DJ027X/nu.ai_motor_controller/README.md

# nu.ai_motor_controller
Designed with KiCAD 5.

You'll also want to grab my custom KiCAD library repo, otherwise parts may not load in.
