DJ027X/nu.ai_motor_controller/nu.ai_motor_controller_firmware/README.txt

To flash firmware onto the conrtoller:
1. Connect the controller to the host machine via USB A to microUSB cable.
2. Hold the ON button on the controller.
3. Run 'bash flash.sh' on the host machine
4. When the flashing process is done, release the ON button, and press the OFF button.
