DJ027X/nu.ai_motor_controller/nu.ai_motor_controller_firmware/firmware_design_document.odt

nu.ai_motor_controller_firmware Design Documentation

Author: Dylan Dailey (djd9617@rit.edu)

Date: April 5 2019

Firmware Version: 1.0

Document Version 1.0

1.0 Overview

The following is an overview of the systems instantiated by the firmware, and which peripherals on the 32u4 microcontroller they occupy.

1.1 Buzzer

The buzzer utilizes timer/counter 0 to generate a desired frequency. The frequency is set by writing a value to OCR0A using the formula OCR0A = 31250 / frequency. For example, to achieve ~440 Hz, one would write 71 (0x47) to OCR0A. OC0A is toggles on a compare match, which will toggle the value of pin 12 (PB7) (PWM_0A), so no interrupts are required to generate the waveform. To enable the output of the waveform, the pin (PB7) must be set as an output. To disable it, PB7 must be set as an input. As discussed in the next section, the timer/counter 3 can also be utilized to generate timed sequences of notes/frequency.

1.2 ADC

The ADC is used to monitor the voltage of each set of parallel cells of the Li-Po battery that is powering the system. The occupied channels are ADC_8, ADC_9, and ADC_11. In order to get meaningful readings from the ADC, the hardware requires that the SNS_EN pin (pin 31) (PC6) be set high for the duration of the reading. In order to achieve periodic activation of the SNS_EN pin, timer/counter 3 is used to generate a square wave of ~8 Hz, and pulse width of ~1 ms. An interrupt is triggered at each overflow of timer/counter 3 (this coincides with the rising edge of the ~8 Hz square wave). This interrupt service routine is used to appropriately set the ADC mux to get a measurement on the correct channel, and initiate the measurement. Incidentally, this interrupt routine lends itself for use as a metronome of sorts to advance the buzzer to the next frequency in a sequence of notes to form a song. If any of the readings indicate that any cell’s voltage is below 3.3 V, the system will shut itself down after giving a low power indication with the buzzer. If any cell’s voltage is above 4.2 V, the system will continue to emit a warning beep until all cells’ voltage is below 4.2 V.

1.3 Motors

Both the left and right motors are controlled with a waveform generated by timer/counter 1. In order to allow the left motors to operate at a different speed than the right motors, the left motors uses the duty cycle set by channel B, and the right motors use the duty cycle set by channel A. The duty cycle is set by writing a value 0x00 – 0xFF to OCR1AL for the right motors, and OCR1BL for the left motors, where 0x00 represents 0% duty cycle and 0xFF represents 100%. The frequency of the waveform is set to ~244 Hz. In theory, the motors should perform best with frequencies in the 100s of Hz, where parasitic inductance is relatively negligible, however no empirical testing has been done to support that on this system. 244 Hz is in the audible range, so you may want to raise this frequency if whining becomes an issue. In order to control the direction of the left motors, pin 22 (PD5) is used, and for the right motors, pin 41 (PF0) is used. In both cases, if the motors are wired correctly, setting the direction pin high will enable the motors to turn such that the vehicle would move forward.
