DJ027X/nu.ai_motor_controller/nuai_motor_controller.png

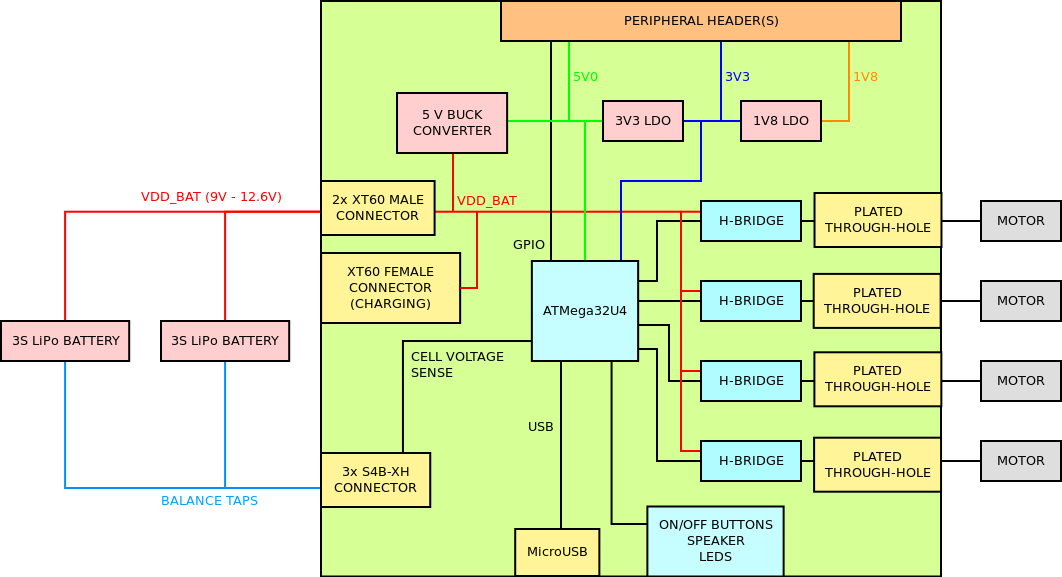
nuai_motor_controller.png
