DJ027X/nu.ai_motor_controller/guard_plate.step

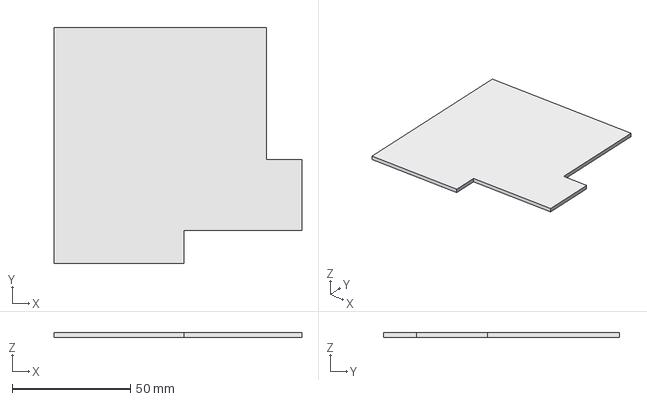
[picture p2: CAD file, 2019-04-19]
guard_plate.step
105.0 x 100.0 x 2.00 mm
