DJ027X/nu.ai_motor_controller/nu.ai_motor_controller.pdf

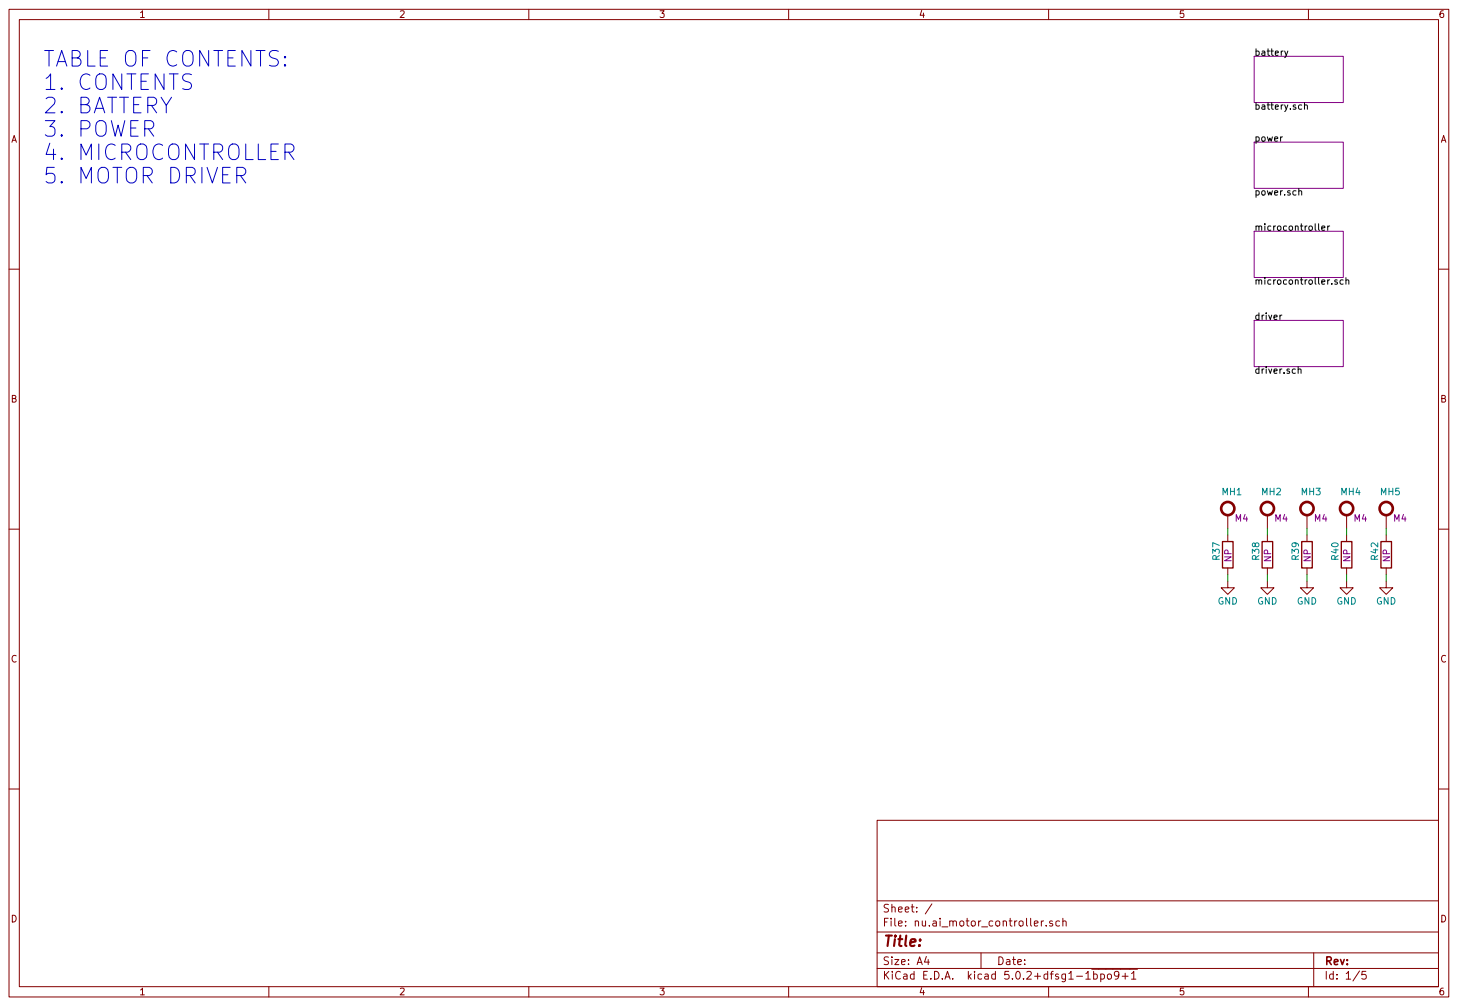
[picture p3: page 1]

driver driver.sch microcontroller microcontroller.sch

File: nu.ai_motor_controller.sch Sheet: /
Id: 1/5 Title:

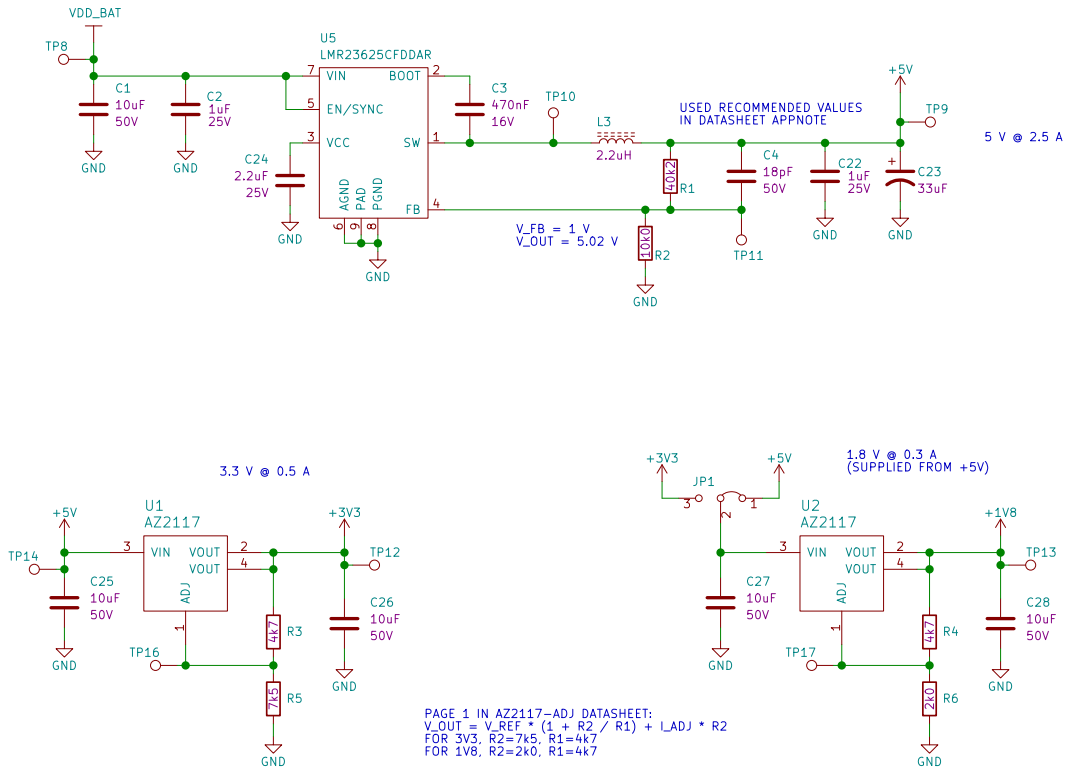
[picture p4: page 2]

PAGE 1 IN AZ2117-ADJ DATASHEET: V_OUT = V_REF * (1 + R2 / R1) + I_ADJ * R2 FOR 3V3, R2=7k5, R1=4k7 FOR 1V8, R2=2k0, R1=4k7 C25

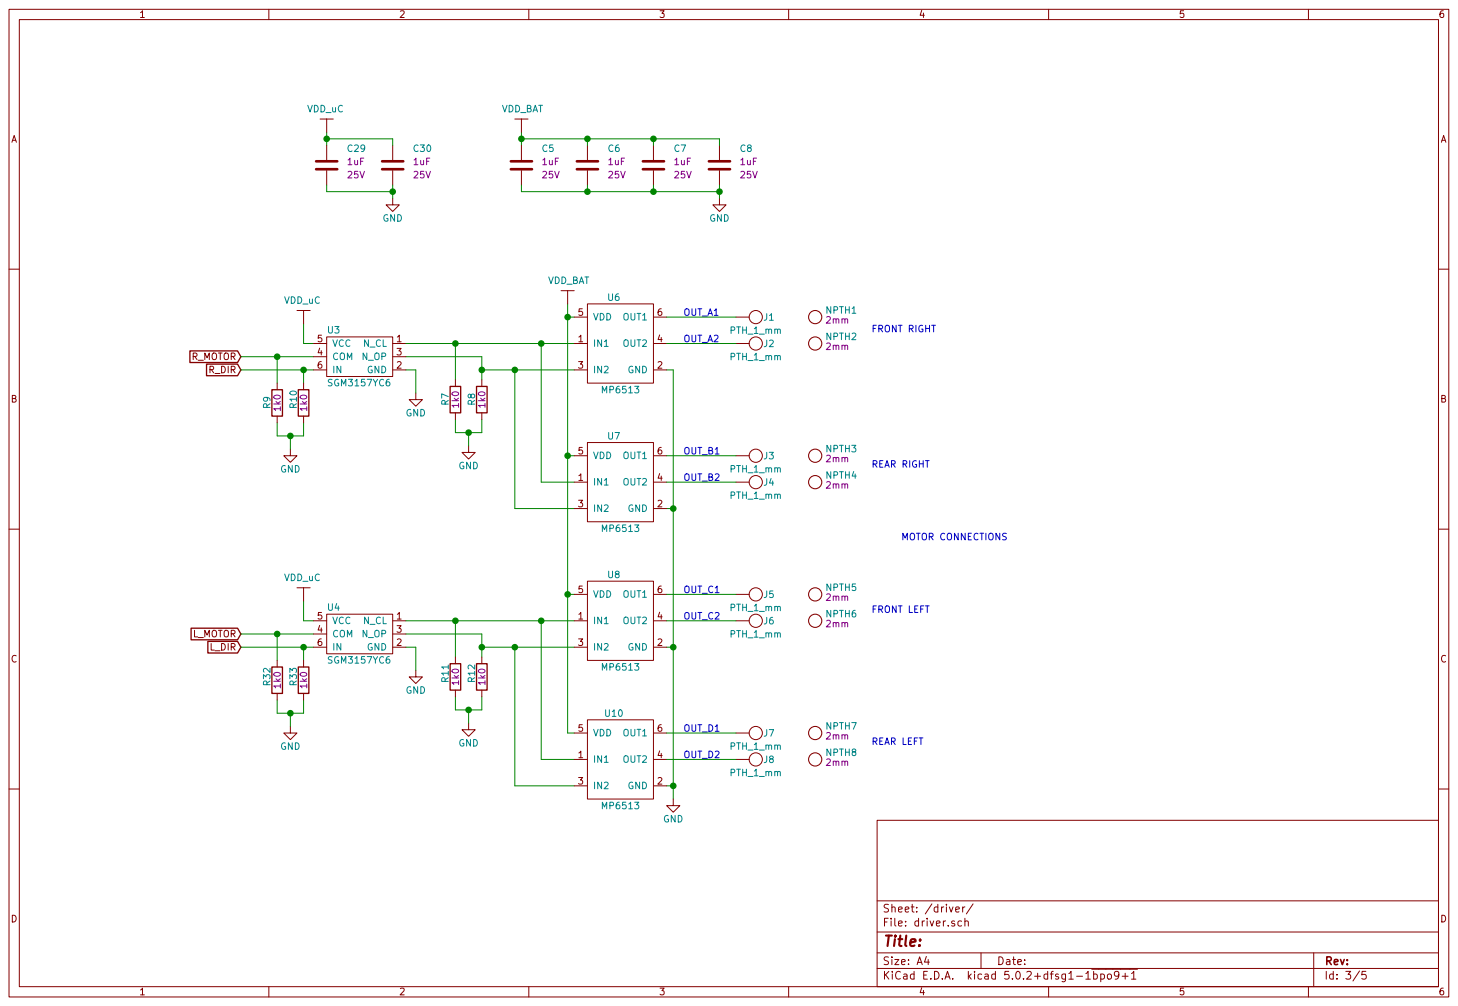
[picture p5: page 3]

VDD_BAT
FRONT RIGHT REAR RIGHT

Id: 3/5 Title: File: driver.sch Sheet: /driver/ GND

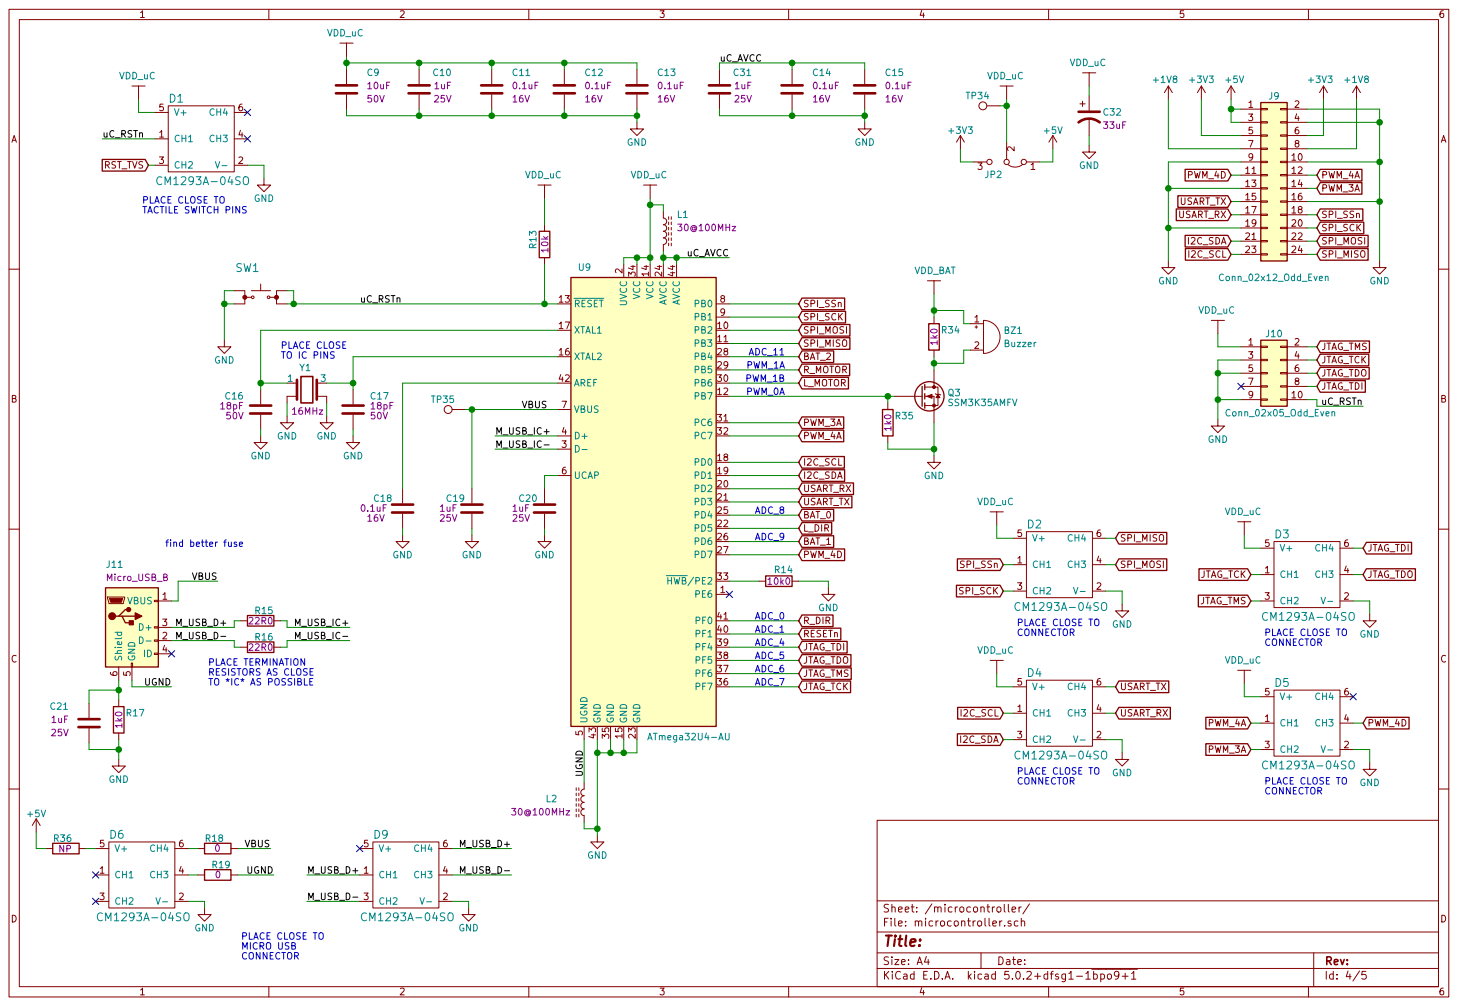
[picture p6: page 4]

2 PD2 20 PD3 21 PD5 22 GND 23 AVCC 24 PD4 25 PD6 26 PD7 27 PB4 28 PB5 29 D- 3 PB6 30 PC6 31 PC7 32 HWB/PE2 33 VCC 34 GND 35 PF7 36 PF6 37 PF5 38 PF4 39 D+ 4 PF1 40 PF0 41 AREF 42 GND 43 AVCC 44 UGND

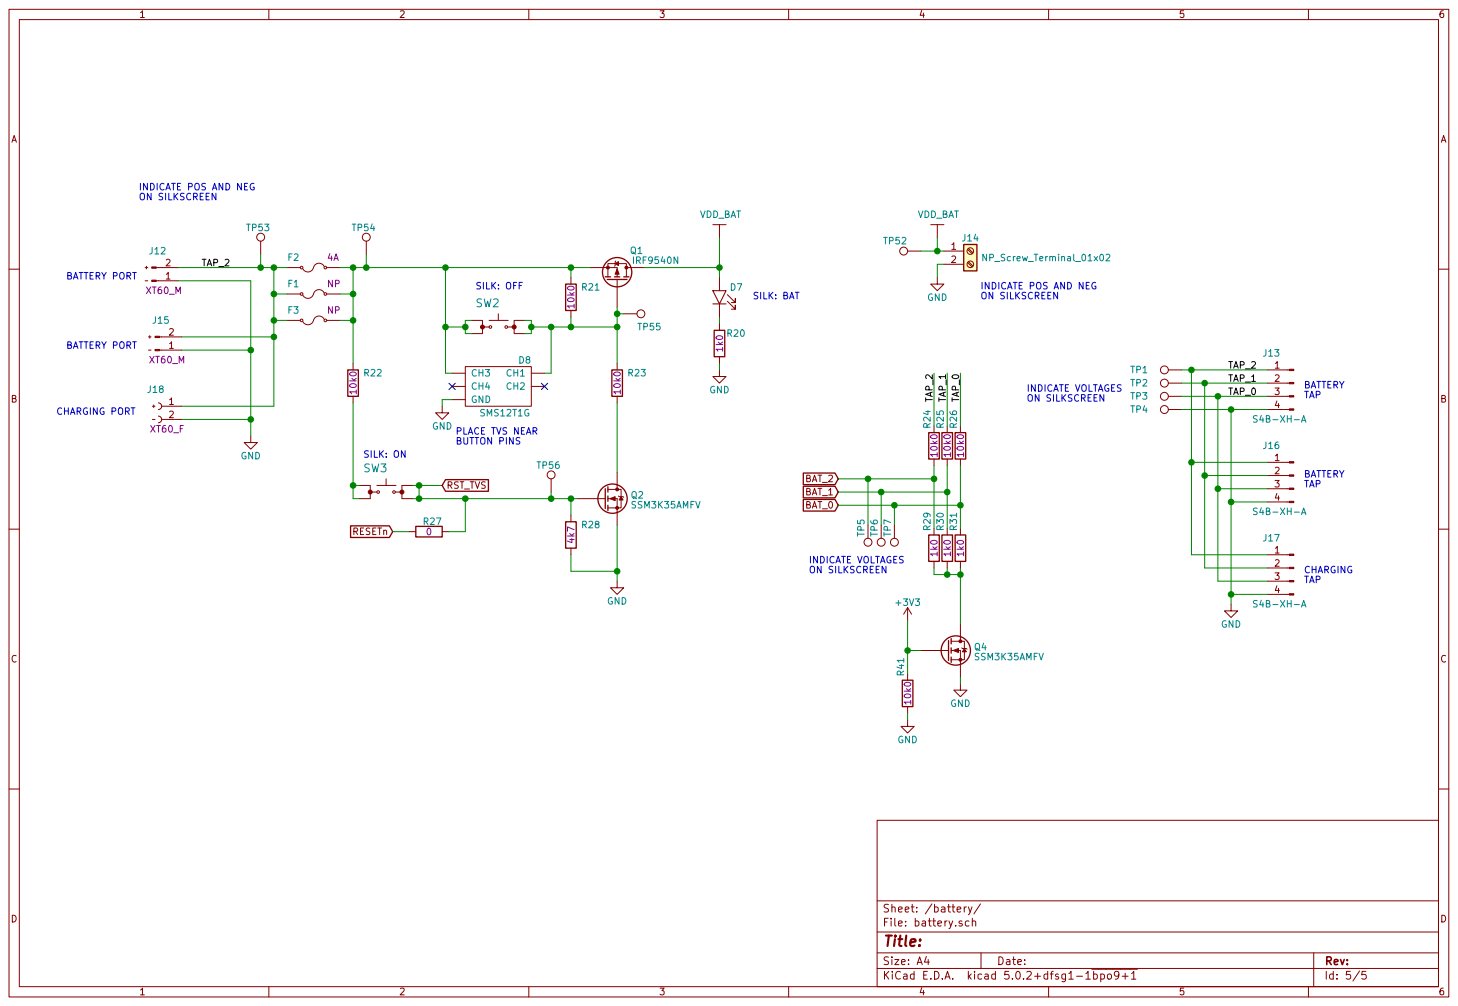
[picture p7: page 5]

INDICATE POS AND NEG
ON SILKSCREEN

INDICATE VOLTAGES ON SILKSCREEN
