DJ027X/nu.ai_motor_controller/nu.ai_motor_controller/layers.pdf

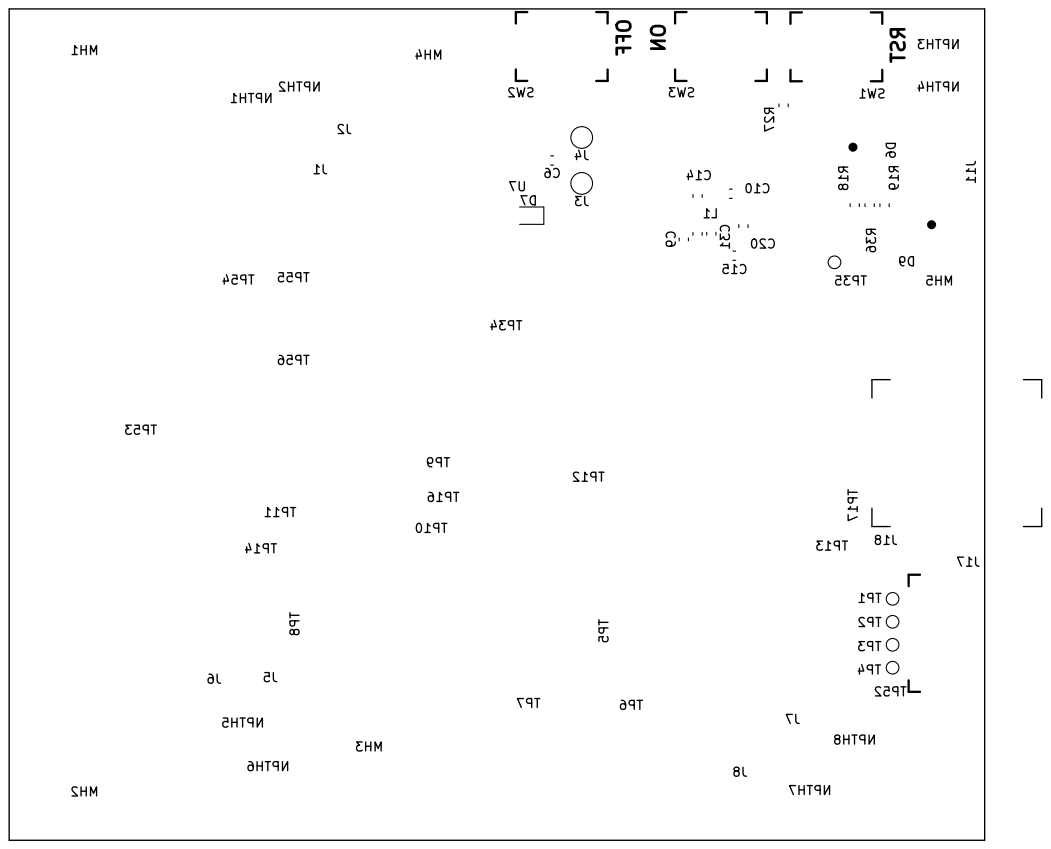
[picture p8: page 2]

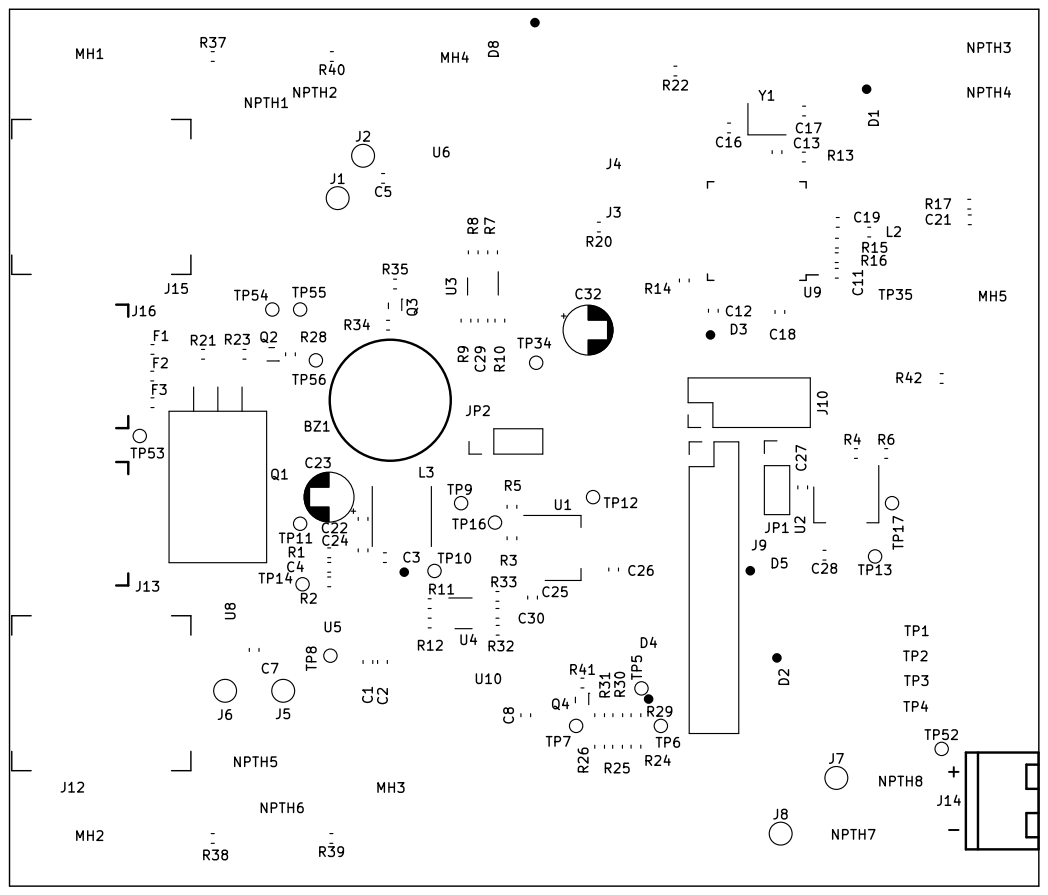
[picture p9: page 3]

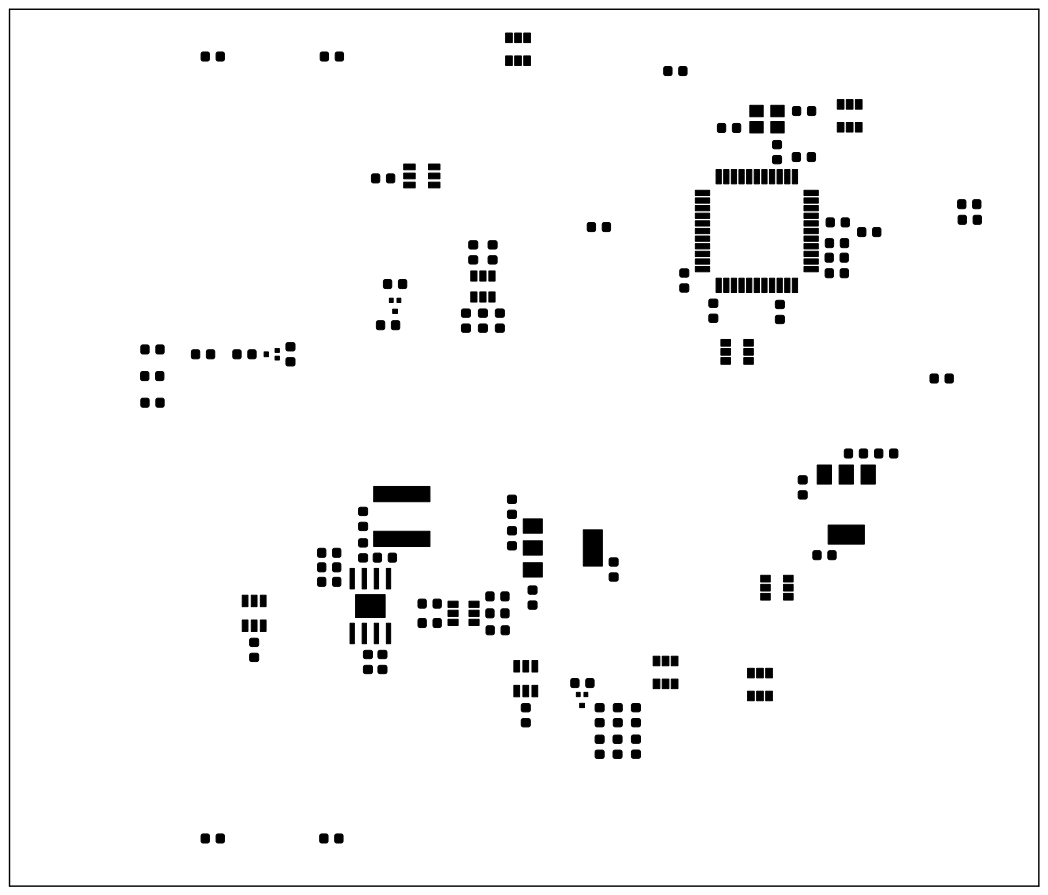
[picture p10: page 4]

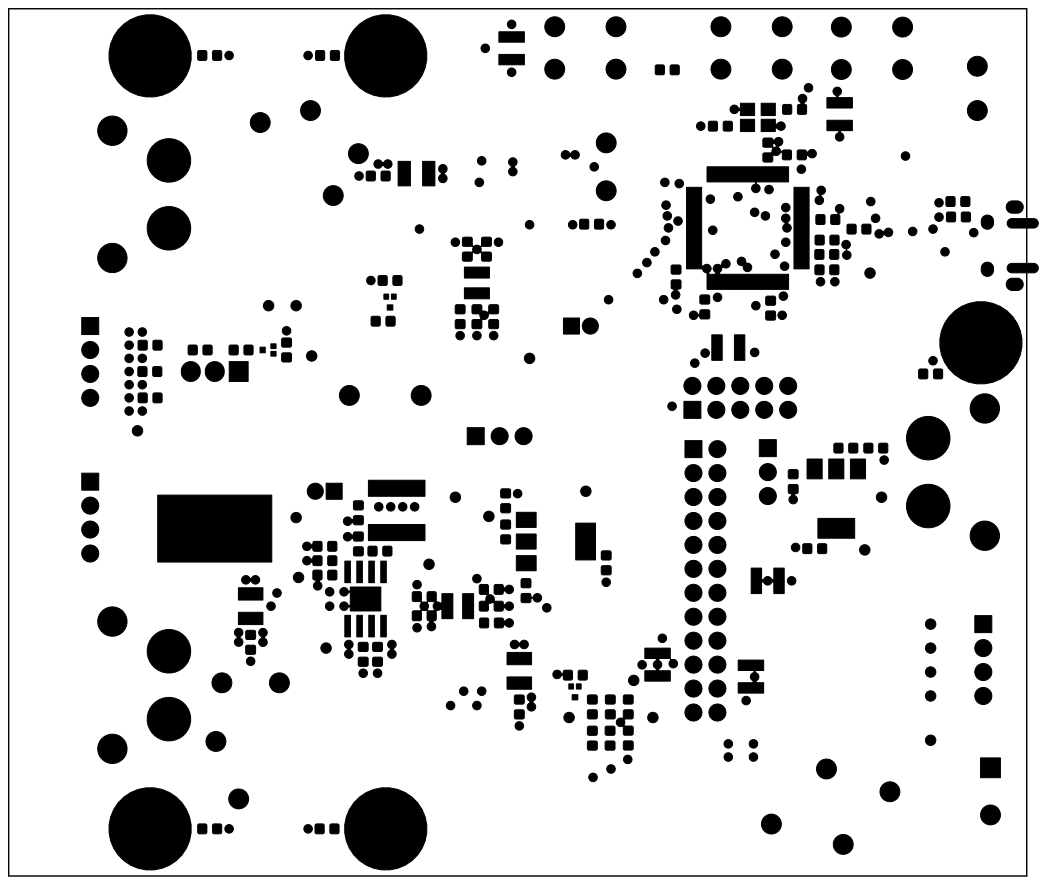
[picture p11: page 5]

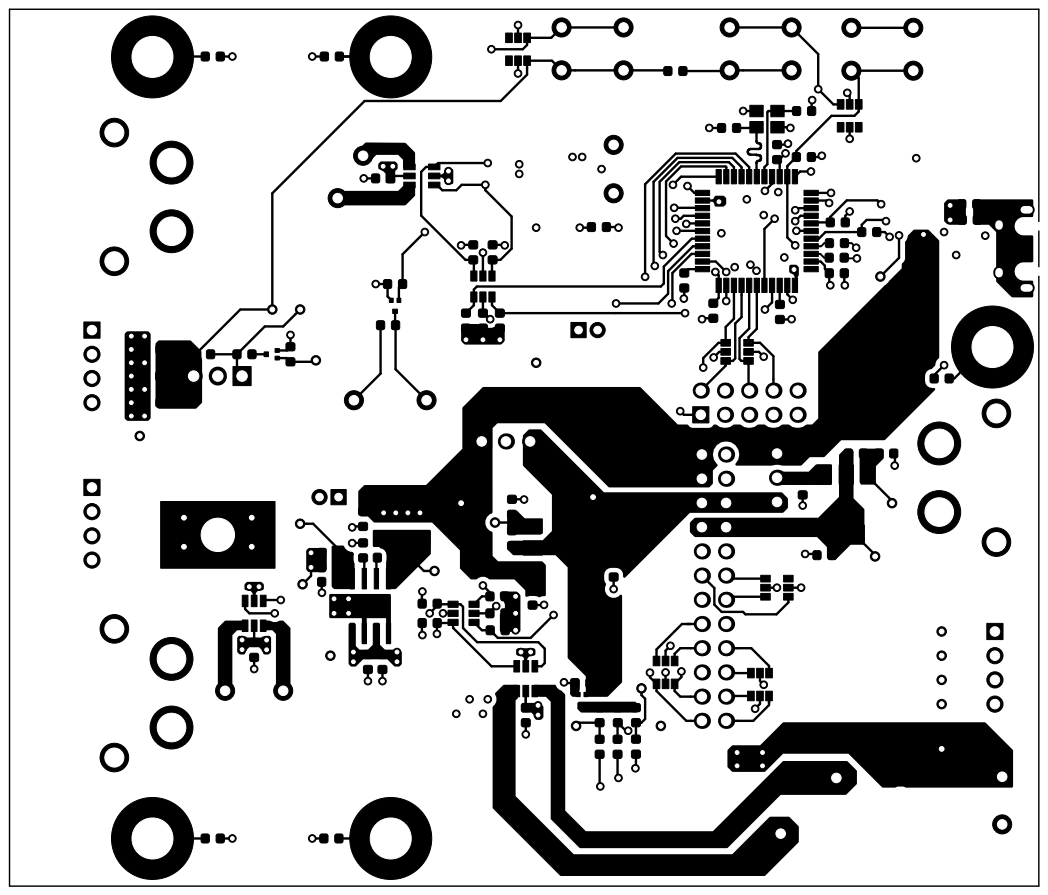
[picture p12: page 6]

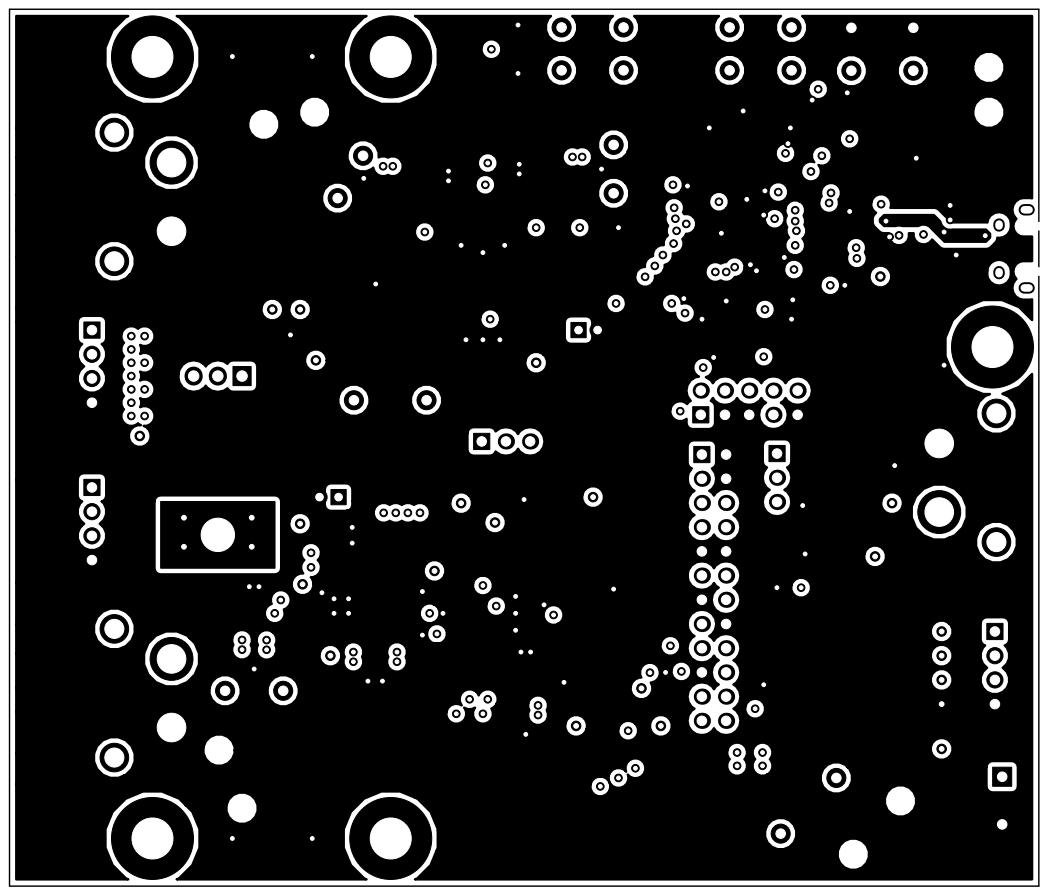
[picture p13: page 7]

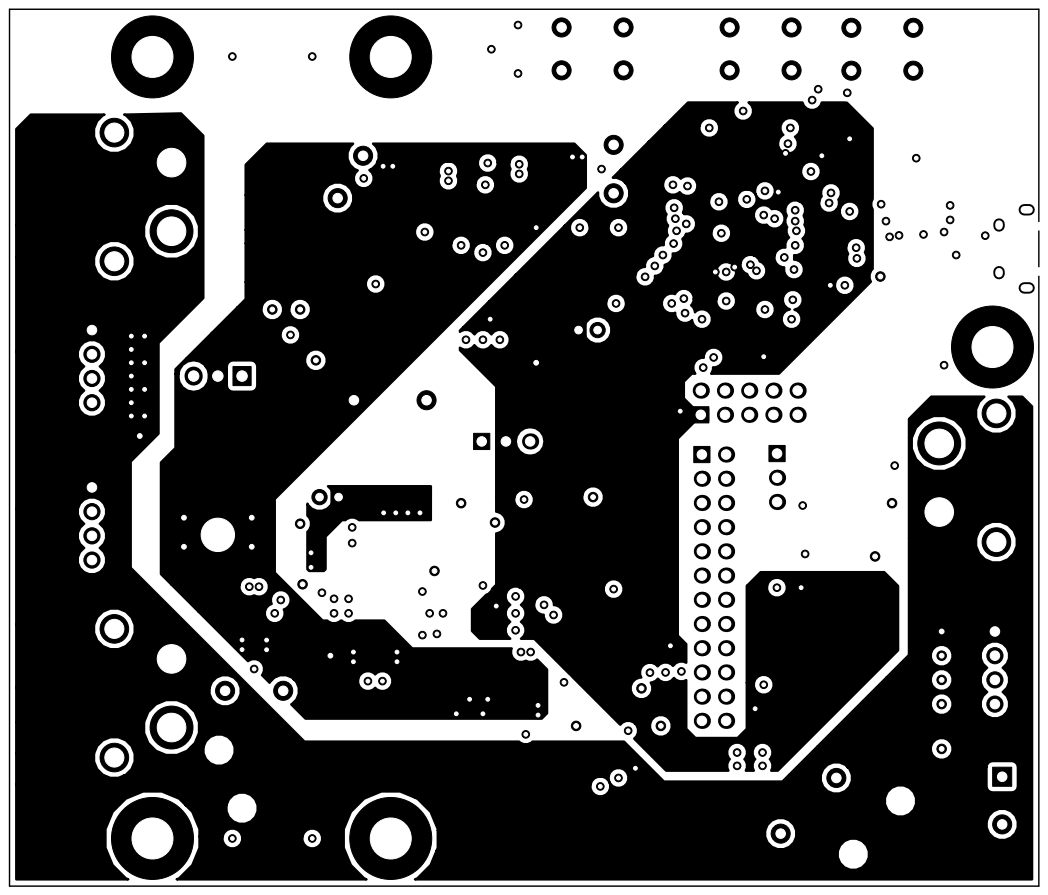
[picture p14: page 8]

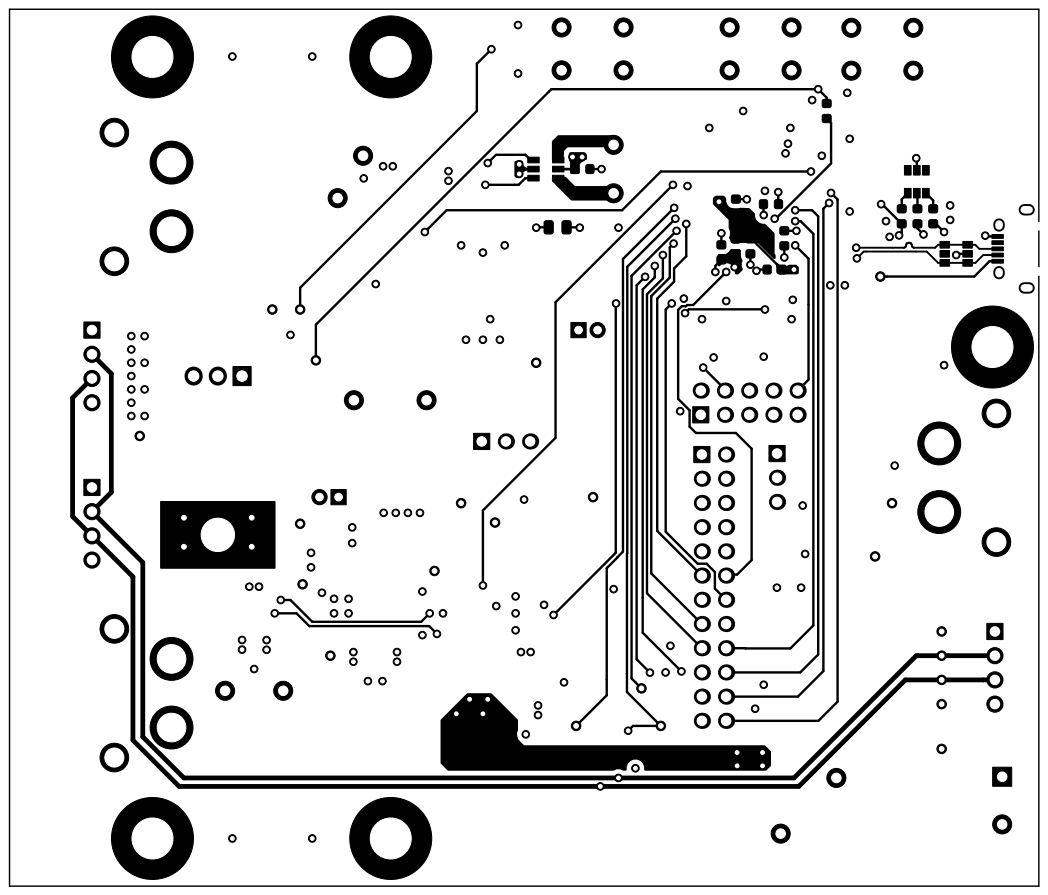
[picture p15: page 9]

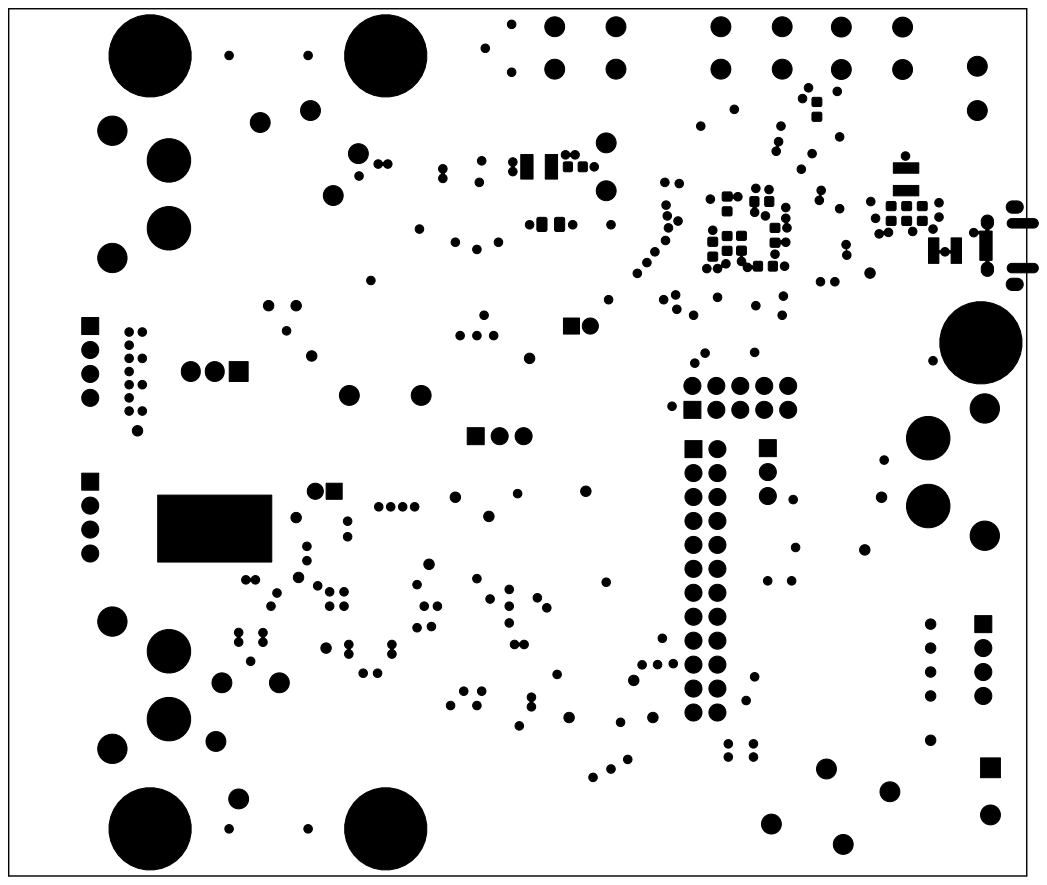
[picture p16: page 10]

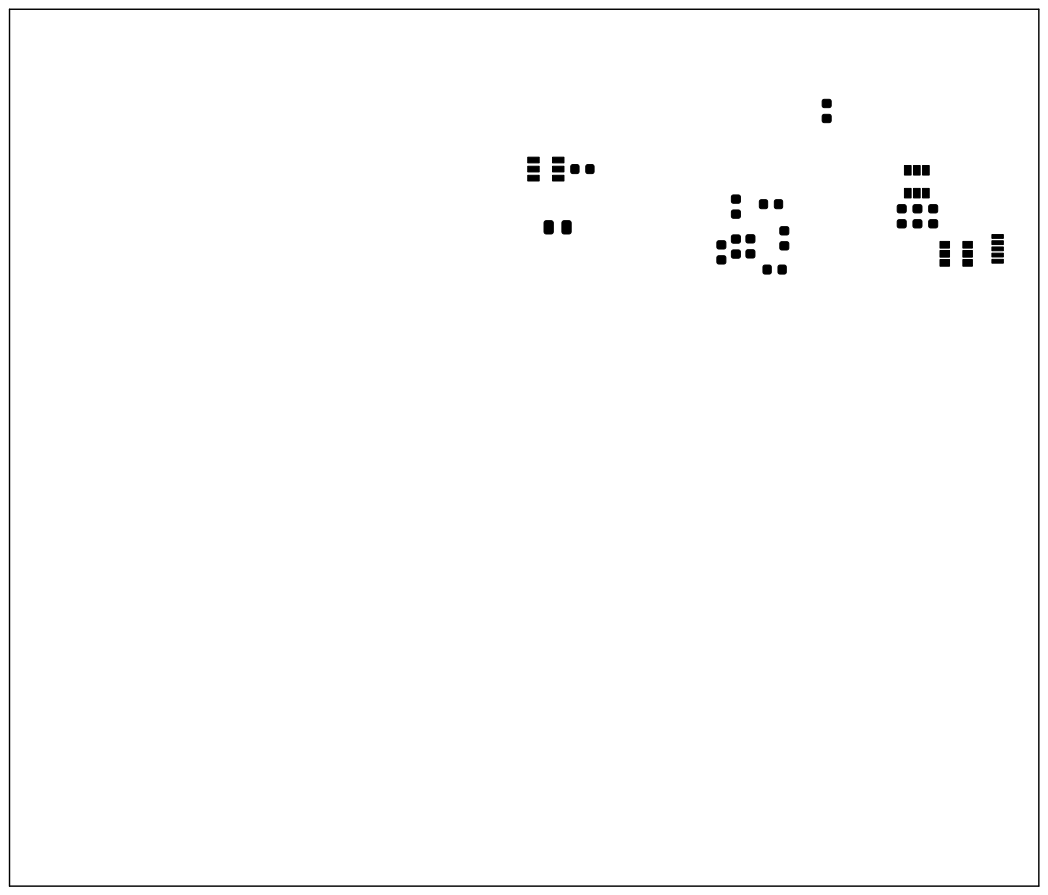
[picture p17: page 11]
