DJ027X/nu.ai_motor_controller/nu.ai_motor_controller/nu.ai_motor_controller.kicad_pcb

## KiCad design nu.ai_motor_controller/nu.ai_motor_controller.kicad_pcb (2019-04-20)

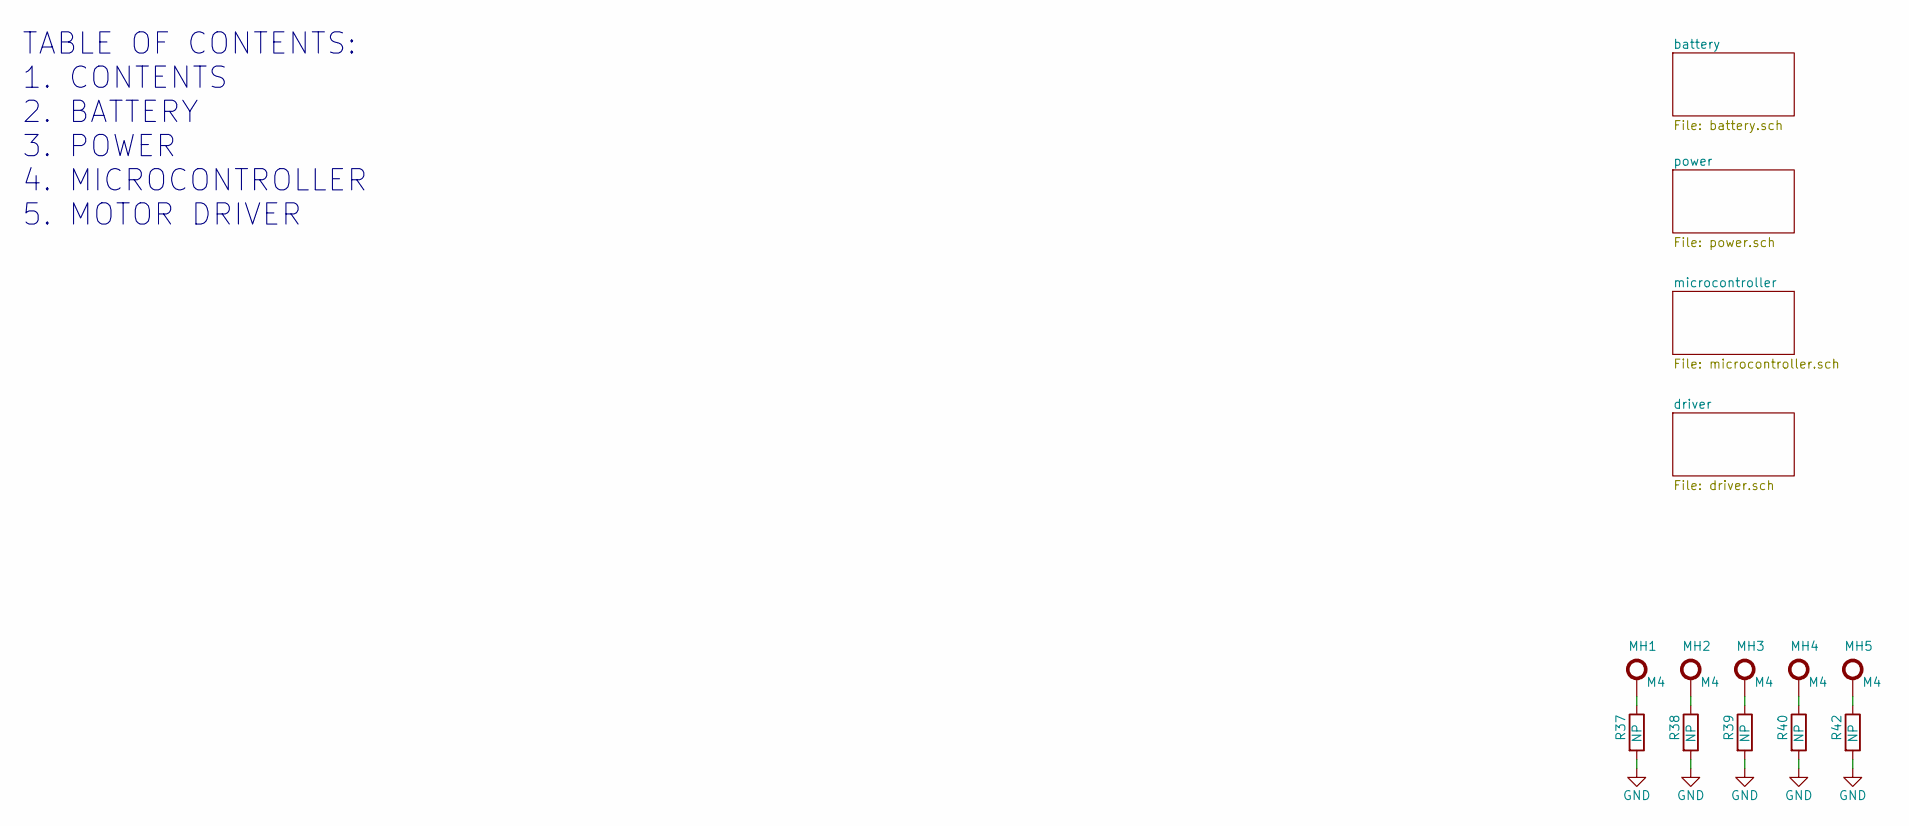
[picture p18: schematic nu.ai_motor_controller.sch]

Parts:
MH1, MH2, MH3, MH4, MH5: M4_MOUNTING_HOLE; MountingHole_4.3mm_M4_Pad
R37, R38, R39, R40, R42: NP_R_0603; NP_0603

Connections:
GND: R37.2, R38.2, R39.2, R40.2, R42.2; also elsewhere on the board
unnamed: MH1.1, R37.1
unnamed: MH2.1, R38.1
unnamed: MH3.1, R39.1
unnamed: MH4.1, R40.1
unnamed: MH5.1, R42.1

Notes on the sheet:
TABLE OF CONTENTS: 1. CONTENTS 2. BATTERY 3. POWER 4. MICROCONTROLLER 5. MOTOR DRIVER

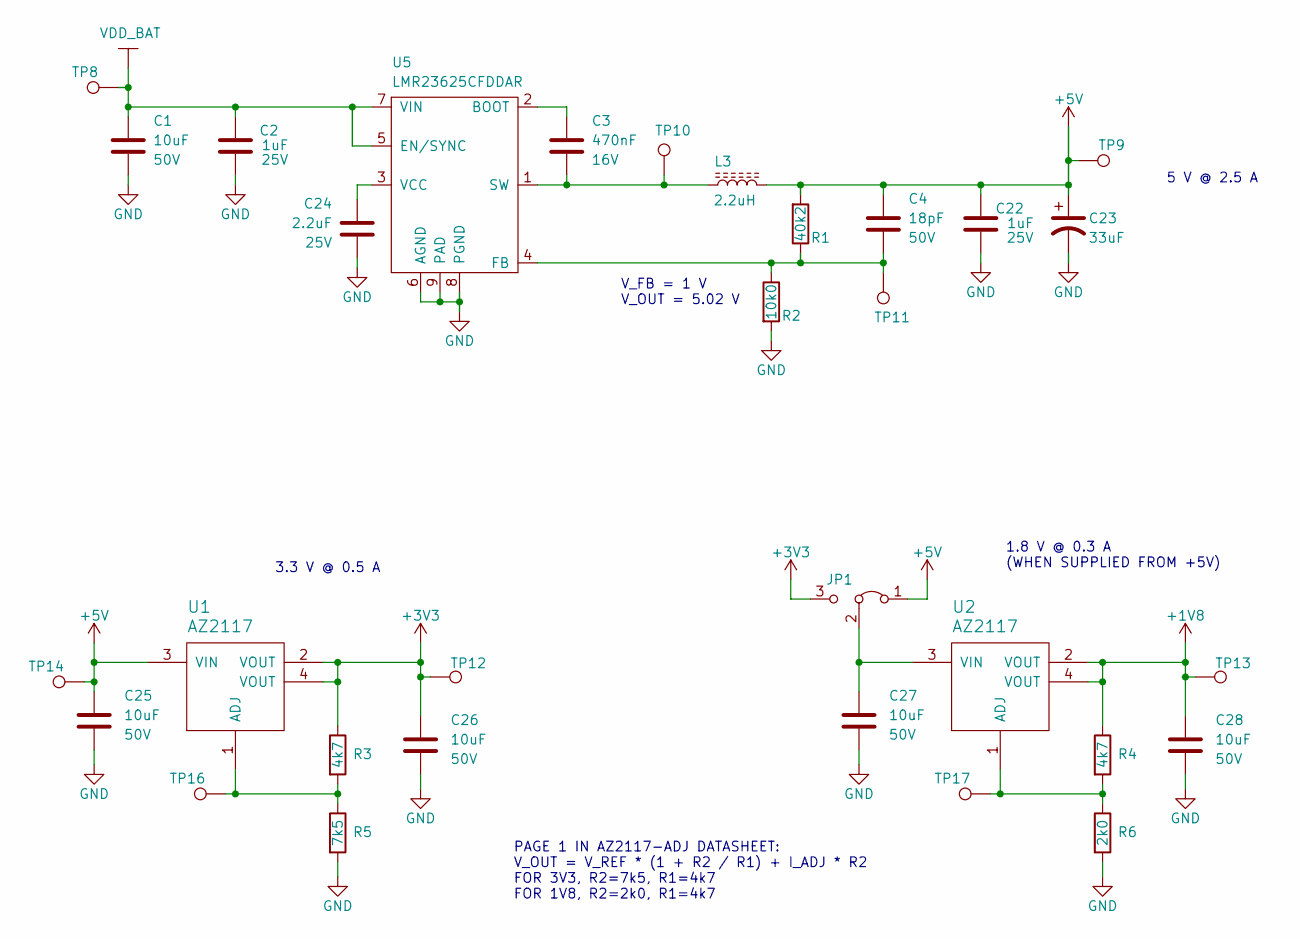
[picture p19: schematic power.sch]

Parts:
C1, C25, C26, C27, C28: CL10B103KB8SFNC; C_0603_1608Metric; Rating 50V
C2, C22: CL10B105KA8NNNC; C_0603_1608Metric; Rating 25V
C3: CL10B474KO8NNNC; C_0603_1608Metric; Rating 16V
C4: C0603C180K5RACAUTO; C_0603_1608Metric; Rating 50V
C23: ESH336M035AC3AA; CP_Radial_D5.0mm_P2.00mm
C24: GRM188R61E225KA12D; C_0603_1608Metric; Rating 25V
JP1: Jumper_3_Bridged12; PinHeader_1x03_P2.54mm_Vertical
L3: NR6028T2R2N; L_Taiyo-Yuden_NR-60xx
R1: RMCF0603FT40K2; R_0603_1608Metric
R2: CR0603-JW-103ELF; R_0603_1608Metric
R3, R4: RMCF0603FT4K70; R_0603_1608Metric
R5: RMCF0603FT7K50; R_0603_1608Metric
R6: RMCF0603FT2K00; R_0603_1608Metric
TP8, TP9, TP10, TP11, TP12, TP13, TP14, TP16, TP17: PTH_0.5_mm; TestPoint_THTPad_D1.0mm_Drill0.5mm
U1, U2: AZ2117; SOT-223
U5: LMR23625CFDDAR; 8-PowerSOIC

Connections:
+1V8: C28.1, R4.1, TP13.1, U2.2 (VOUT), U2.4 (VOUT); also elsewhere on the board
+3V3: C26.1, JP1.3 (B), R3.1, TP12.1, U1.2 (VOUT), U1.4 (VOUT); also elsewhere on the board
+5V: C4.1, C22.1, C23.1, C25.1, JP1.1 (A), L3.2, R1.1, TP9.1, TP14.1, U1.3 (VIN); also elsewhere on the board
GND: C1.2, C2.2, C22.2, C23.2, C24.2, C25.2, C26.2, C27.2, C28.2, R2.2, R5.2, R6.2, U5.6 (AGND), U5.8 (PGND), U5.9 (PAD); also elsewhere on the board
unnamed: C3.1, U5.2 (BOOT)
unnamed: C3.2, L3.1, TP10.1, U5.1 (SW)
unnamed: C4.2, R1.2, R2.1, TP11.1, U5.4 (FB)
unnamed: C24.1, U5.3 (VCC)
unnamed: C27.1, JP1.2 (C), U2.3 (VIN)
unnamed: R3.2, R5.1, TP16.1, U1.1 (ADJ)
unnamed: R4.2, R6.1, TP17.1, U2.1 (ADJ)
VDD_BAT: C1.1, C2.1, TP8.1, U5.5 (EN/SYNC), U5.7 (VIN); also elsewhere on the board

Notes on the sheet:
V_FB = 1 V V_OUT = 5.02 V
5 V @ 2.5 A
PAGE 1 IN AZ2117-ADJ DATASHEET: V_OUT = V_REF * (1 + R2 / R1) + I_ADJ * R2 FOR 3V3, R2=7k5, R1=4k7 FOR 1V8, R2=2k0, R1=4k7
3.3 V @ 0.5 A
1.8 V @ 0.3 A (WHEN SUPPLIED FROM +5V)

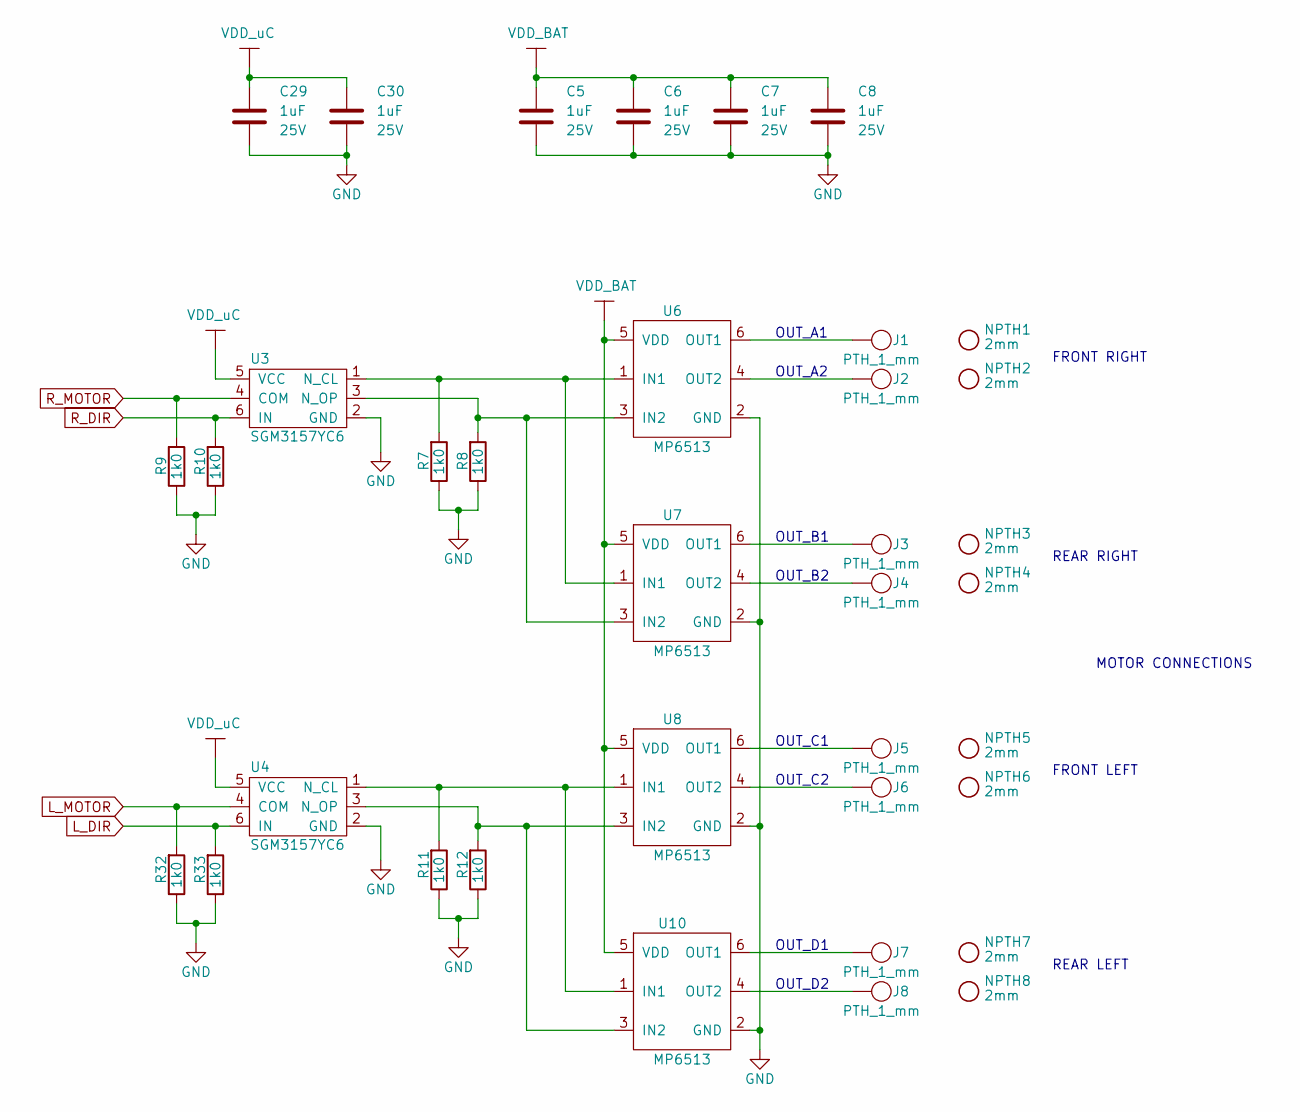
[picture p20: schematic driver.sch]

Parts:
C5, C6, C7, C8, C29, C30: CL10B105KA8NNNC; C_0603_1608Metric; Rating 25V
J1, J2, J3, J4, J5, J6, J7, J8: PTH_1_mm; TestPoint_THTPad_D2.0mm_Drill1.0mm
NPTH1, NPTH2, NPTH3, NPTH4, NPTH5, NPTH6, NPTH7, NPTH8: NPTH_2mm
R7, R8, R9, R10, R11, R12, R32, R33: RC0603JR-071KL; R_0603_1608Metric
U3, U4: SGM3157YC6; SOT-363_SC-70-6
U6, U7, U8, U10: MP6513; TSOT23-6

Connections:
GND: C5.2, C6.2, C7.2, C8.2, C29.2, C30.2, R7.2, R8.2, R9.2, R10.2, R11.2, R12.2, R32.2, R33.2, U3.2 (GND), U4.2 (GND), U6.2 (GND), U7.2 (GND), U8.2 (GND), U10.2 (GND); also elsewhere on the board
L_DIR: R33.1, U4.6 (IN); also elsewhere on the board
L_MOTOR: R32.1, U4.4 (COM); also elsewhere on the board
unnamed: J1.1, U6.6 (OUT1)
unnamed: J2.1, U6.4 (OUT2)
unnamed: J3.1, U7.6 (OUT1)
unnamed: J4.1, U7.4 (OUT2)
unnamed: J5.1, U8.6 (OUT1)
unnamed: J6.1, U8.4 (OUT2)
unnamed: J7.1, U10.6 (OUT1)
unnamed: J8.1, U10.4 (OUT2)
unnamed: R7.1, U3.1 (N_CL), U6.1 (IN1), U7.1 (IN1)
unnamed: R8.1, U3.3 (N_OP), U6.3 (IN2), U7.3 (IN2)
unnamed: R11.1, U4.1 (N_CL), U8.1 (IN1), U10.1 (IN1)
unnamed: R12.1, U4.3 (N_OP), U8.3 (IN2), U10.3 (IN2)
R_DIR: R10.1, U3.6 (IN); also elsewhere on the board
R_MOTOR: R9.1, U3.4 (COM); also elsewhere on the board
VDD_BAT: C5.1, C6.1, C7.1, C8.1, U6.5 (VDD), U7.5 (VDD), U8.5 (VDD), U10.5 (VDD); also elsewhere on the board
VDD_uC: C29.1, C30.1, U3.5 (VCC), U4.5 (VCC); also elsewhere on the board

Notes on the sheet:
OUT_A1
OUT_A2
OUT_B1
OUT_B2
OUT_C1
OUT_C2
OUT_D1
OUT_D2
MOTOR CONNECTIONS
FRONT RIGHT
REAR RIGHT
FRONT LEFT
REAR LEFT

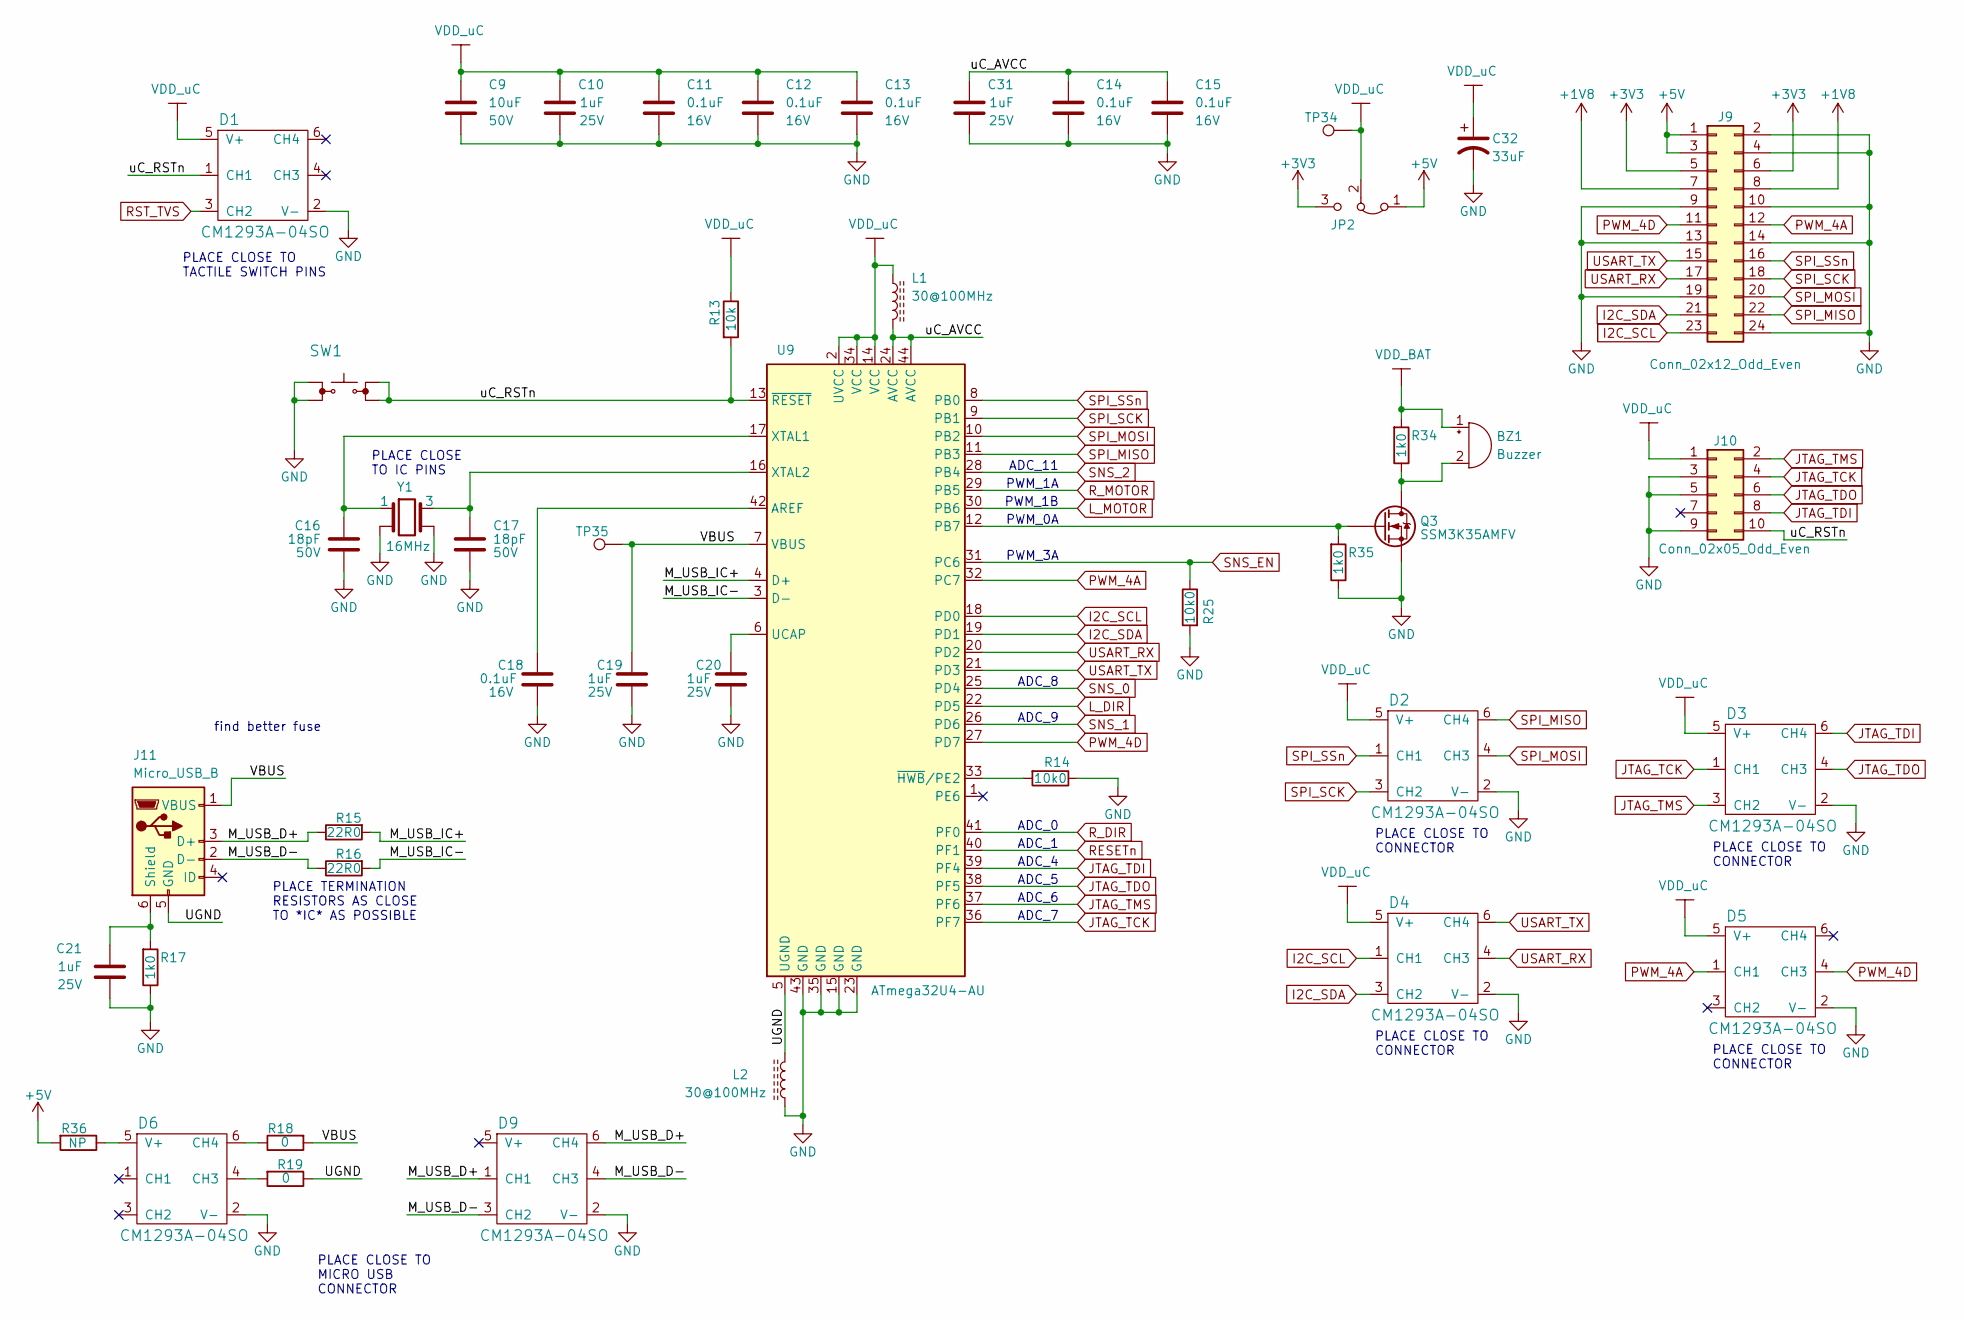
[picture p21: schematic microcontroller.sch]

Parts:
BZ1: Buzzer; 0.5_IN_BUZZER
C9: CL10B103KB8SFNC; C_0603_1608Metric; Rating 50V
C10, C19, C20, C21, C31: CL10B105KA8NNNC; C_0603_1608Metric; Rating 25V
C11, C12, C13, C14, C15, C18: CL10B104KO8NNNC; C_0603_1608Metric; Rating 16V
C16, C17: C0603C180K5RACAUTO; C_0603_1608Metric; Rating 50V
C32: ESH336M035AC3AA; CP_Radial_D5.0mm_P2.00mm
D1, D2, D3, D4, D5, D6, D9: CM1293A-04SO; SOT-457
J9: Conn_02x12_Odd_Even; PinHeader_2x12_P2.54mm_Vertical
J10: Conn_02x05_Odd_Even; PinHeader_2x05_P2.54mm_Vertical
J11: DX4R105JJCR1800; DX4R105JJCR1800‎_MICRO_USB_B_CONNECTOR
JP2: Jumper_3_Bridged12; PinHeader_1x03_P2.54mm_Vertical
L1, L2: CIS10P300AC; L_0603_1608Metric
Q3: SSM3K35AMFV; SOT-723
R13, R14, R25: CR0603-JW-103ELF; R_0603_1608Metric
R15, R16: RMCF0603FT22R0; R_0603_1608Metric
R17, R34, R35: RC0603JR-071KL; R_0603_1608Metric
R18, R19: RC0603JR-070RL; R_0603_1608Metric
R36: NP_R_0603; NP_0603
SW1: TACTILE_SWITCH
TP34, TP35: PTH_0.5_mm; TestPoint_THTPad_D1.0mm_Drill0.5mm
U9: ATmega32U4-AU; TQFP-44_10x10mm_P0.8mm
Y1: 7M-16.000MAAE-T; Crystal_SMD_3225-4Pin_3.2x2.5mm

Connections:
+1V8: J9.7, J9.8; also elsewhere on the board
+3V3: J9.5, J9.6, JP2.3 (B); also elsewhere on the board
+5V: J9.1, J9.3, JP2.1 (A), R36.2; also elsewhere on the board
/microcontroller/M_USB_D+: D9.1 (CH1), D9.6 (CH4), J11.3 (D+), R15.2
/microcontroller/M_USB_D-: D9.3 (CH2), D9.4 (CH3), J11.2 (D-), R16.2
/microcontroller/M_USB_IC+: R15.1, U9.4 (D+)
/microcontroller/M_USB_IC-: R16.1, U9.3 (D-)
/microcontroller/UGND: J11.5 (GND), L2.1, R19.1, U9.5 (UGND)
/microcontroller/VBUS: C19.1, J11.1 (VBUS), R18.2, TP35.1, U9.7 (VBUS)
/microcontroller/uC_AVCC: C14.1, C15.1, C31.1, L1.2, U9.24 (AVCC), U9.44 (AVCC)
/microcontroller/uC_RSTn: D1.1 (CH1), J10.10, R13.2, SW1.2, U9.13 (~RESET)
GND: C9.2, C10.2, C11.2, C12.2, C13.2, C14.2, C15.2, C16.2, C17.2, C18.2, C19.2, C20.2, C21.2, C31.2, C32.2, D1.2 (V-), D2.2 (V-), D3.2 (V-), D4.2 (V-), D5.2 (V-), D6.2 (V-), D9.2 (V-), J9.2, J9.4, J9.9, J9.10, J9.13, J9.14, J9.19, J9.24, J10.3, J10.5, J10.9, L2.2, Q3.2 (S), R14.1, R17.2, R25.2, R35.2, SW1.1, U9.15 (GND), U9.23 (GND), U9.35 (GND), U9.43 (GND), Y1.2, Y1.4; also elsewhere on the board
I2C_SCL: D4.1 (CH1), J9.23, U9.18 (PD0)
I2C_SDA: D4.3 (CH2), J9.21, U9.19 (PD1)
JTAG_TCK: D3.1 (CH1), J10.4, U9.36 (PF7)
JTAG_TDI: D3.6 (CH4), J10.8, U9.39 (PF4)
JTAG_TDO: D3.4 (CH3), J10.6, U9.38 (PF5)
JTAG_TMS: D3.3 (CH2), J10.2, U9.37 (PF6)
L_DIR: U9.22 (PD5); also elsewhere on the board
L_MOTOR: U9.30 (PB6); also elsewhere on the board
unnamed: BZ1.2 (+), Q3.3 (D), R34.2
unnamed: C16.1, U9.17 (XTAL1), Y1.1
unnamed: C17.1, U9.16 (XTAL2), Y1.3
unnamed: C18.1, U9.42 (AREF)
unnamed: C20.1, U9.6 (UCAP)
unnamed: C21.1, J11.6 (Shield), R17.1
unnamed: D6.4 (CH3), R19.2
unnamed: D6.5 (V+), R36.1
unnamed: D6.6 (CH4), R18.1
unnamed: Q3.1 (G), R35.1, U9.12 (PB7)
unnamed: R14.2, U9.33 (~HWB~/PE2)
PWM_4A: D5.1 (CH1), J9.12, U9.32 (PC7)
PWM_4D: D5.4 (CH3), J9.11, U9.27 (PD7)
RESETn: U9.40 (PF1); also elsewhere on the board
RST_TVS: D1.3 (CH2); also elsewhere on the board
R_DIR: U9.41 (PF0); also elsewhere on the board
R_MOTOR: U9.29 (PB5); also elsewhere on the board
SNS_0: U9.25 (PD4); also elsewhere on the board
SNS_1: U9.26 (PD6); also elsewhere on the board
SNS_2: U9.28 (PB4); also elsewhere on the board
SNS_EN: R25.1, U9.31 (PC6); also elsewhere on the board
SPI_MISO: D2.6 (CH4), J9.22, U9.11 (PB3)
SPI_MOSI: D2.4 (CH3), J9.20, U9.10 (PB2)
SPI_SCK: D2.3 (CH2), J9.18, U9.9 (PB1)
SPI_SSn: D2.1 (CH1), J9.16, U9.8 (PB0)
USART_RX: D4.4 (CH3), J9.17, U9.20 (PD2)
USART_TX: D4.6 (CH4), J9.15, U9.21 (PD3)
VDD_BAT: BZ1.1 (-), R34.1; also elsewhere on the board
VDD_uC: C9.1, C10.1, C11.1, C12.1, C13.1, C32.1, D1.5 (V+), D2.5 (V+), D3.5 (V+), D4.5 (V+), D5.5 (V+), J10.1, JP2.2 (C), L1.1, R13.1, TP34.1, U9.2 (UVCC), U9.14 (VCC), U9.34 (VCC); also elsewhere on the board

Notes on the sheet:
PLACE TERMINATION RESISTORS AS CLOSE TO *IC* AS POSSIBLE
PLACE CLOSE TO MICRO USB CONNECTOR
PLACE CLOSE TO IC PINS
ADC_11
PWM_1A
PWM_1B
ADC_8
ADC_9
ADC_0
ADC_1
ADC_4
ADC_5
ADC_6
ADC_7
PLACE CLOSE TO TACTILE SWITCH PINS
PWM_0A
PLACE CLOSE TO CONNECTOR
find better fuse
PWM_3A

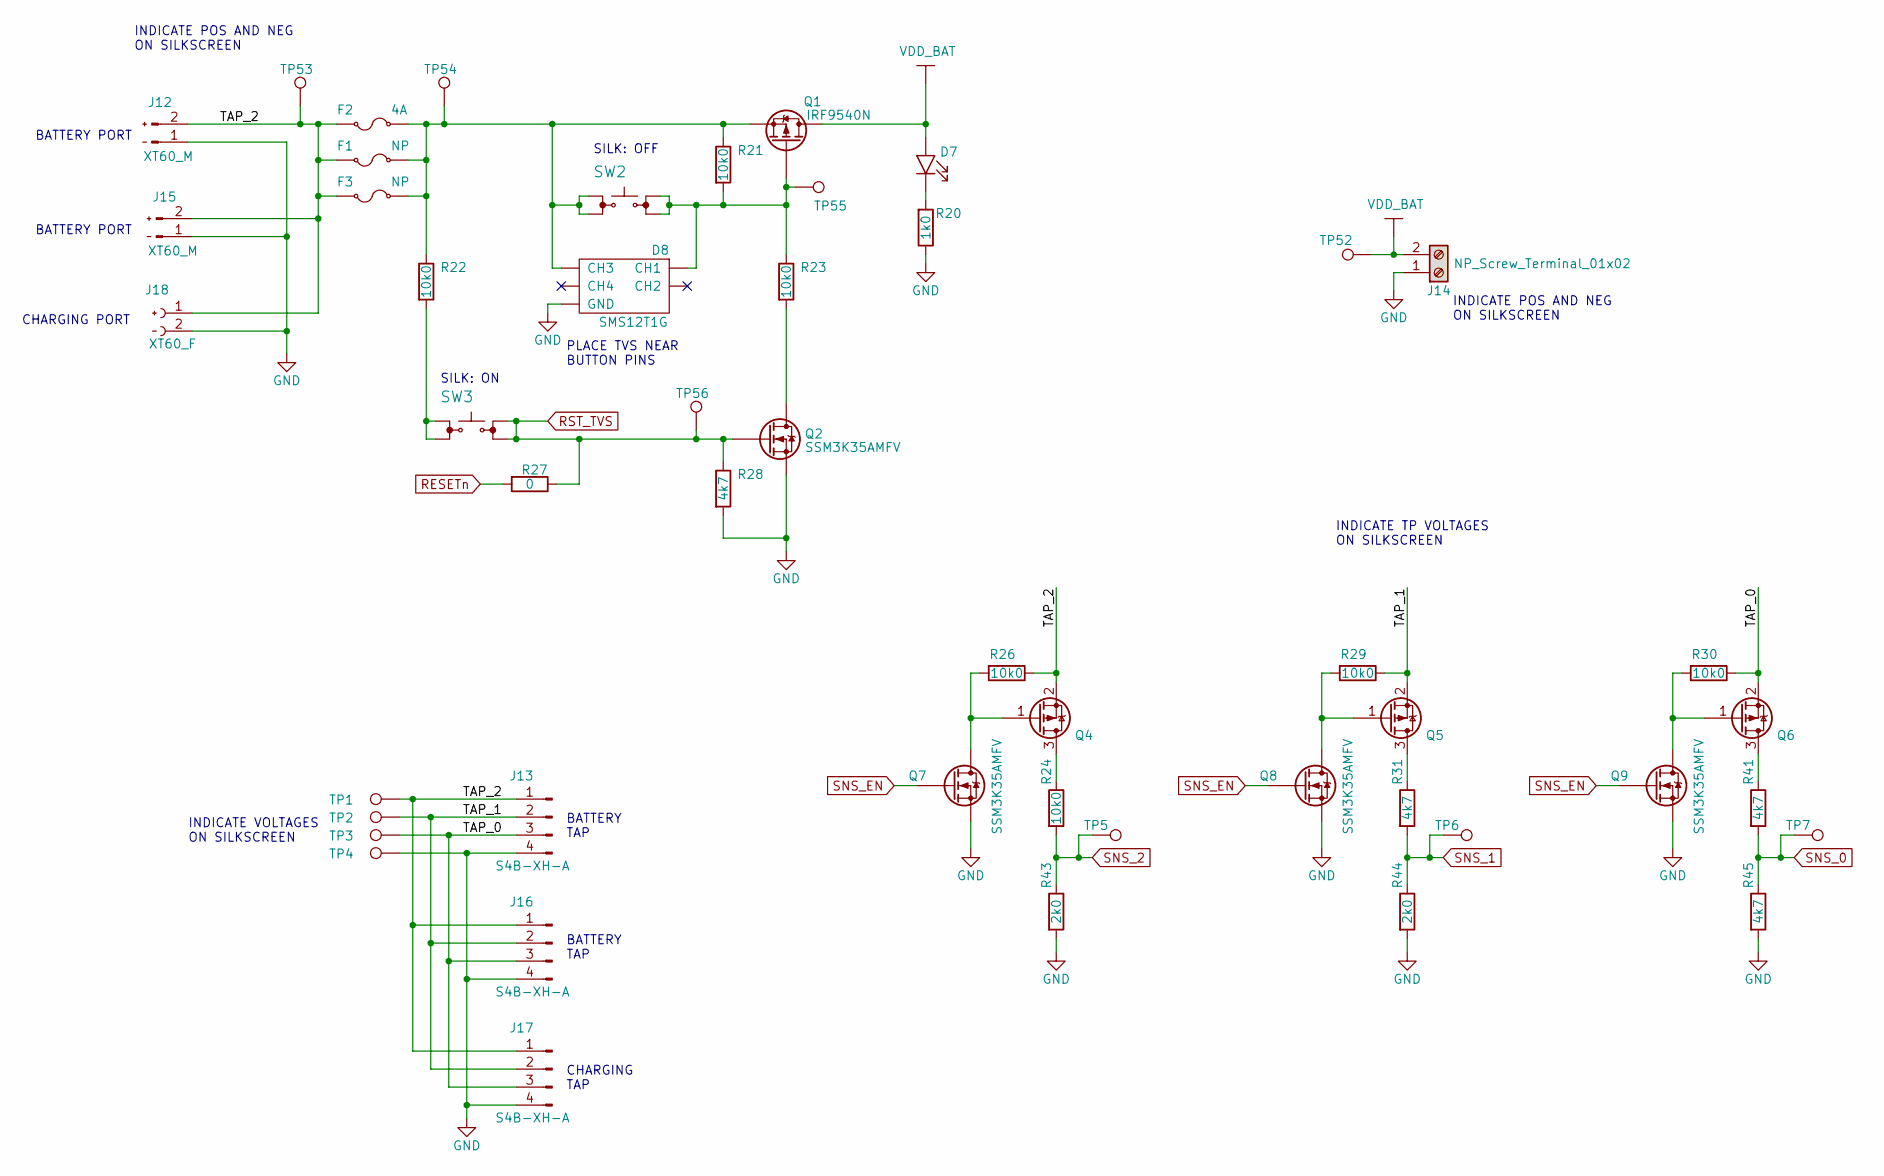
[picture p22: schematic battery.sch]

Parts:
D7: LED_GENERIC_0805; D_0805_2012Metric
D8: SMS12T1G; SOT-457
F1, F3: NP_FUSE_0603; Fuse_0603_1608Metric
F2: ERB-RE4R00V; Fuse_0603_1608Metric; rating 4A
J12, J15: XT60_RA_MALE; XT60PW
J13, J16, J17: S4B-XH-A; X4B-XH-A
J14: NP_Screw_Terminal_01x02; TERMINAL_BLOCK_1x2
J18: XT60_RA_FEMALE; XT60PW
Q1: IRF9540N; TO-220-3_Horizontal_TabDown
Q2, Q7, Q8, Q9: SSM3K35AMFV; SOT-723
Q4, Q5, Q6: AO3407A; SOT-23
R20: RC0603JR-071KL; R_0603_1608Metric
R21, R22, R23, R24, R26, R29, R30: CR0603-JW-103ELF; R_0603_1608Metric
R27: RC0603JR-070RL; R_0603_1608Metric
R28, R31, R41, R45: RMCF0603FT4K70; R_0603_1608Metric
R43, R44: RMCF0603FT2K00; R_0603_1608Metric
SW2, SW3: TACTILE_SWITCH
TP1, TP2, TP3, TP4, TP5, TP6, TP7, TP52, TP53, TP54, TP55, TP56: PTH_0.5_mm; TestPoint_THTPad_D1.0mm_Drill0.5mm

Connections:
/battery/TAP_0: J13.3, J16.3, J17.3, Q6.2 (S), R30.1, TP3.1
/battery/TAP_1: J13.2, J16.2, J17.2, Q5.2 (S), R29.1, TP2.1
/battery/TAP_2: F1.1, F2.1, F3.1, J12.2, J13.1, J15.2, J16.1, J17.1, J18.1, Q4.2 (S), R26.1, TP1.1, TP53.1
GND: D8.2 (GND), D8.5 (GND), J12.1, J13.4, J14.1, J15.1, J16.4, J17.4, J18.2, Q2.2 (S), Q7.2 (S), Q8.2 (S), Q9.2 (S), R20.2, R28.2, R43.2, R44.2, R45.2, TP4.1; also elsewhere on the board
unnamed: D7.1 (K), R20.1
unnamed: D8.1 (CH1), Q1.1 (G), R21.2, R23.1, SW2.2, TP55.1
unnamed: D8.6 (CH3), F1.2, F2.2, F3.2, Q1.3 (S), R21.1, R22.1, SW2.1, TP54.1
unnamed: Q2.3 (D), R23.2
unnamed: Q4.1 (G), Q7.3 (D), R26.2
unnamed: Q4.3 (D), R24.1
unnamed: Q5.1 (G), Q8.3 (D), R29.2
unnamed: Q5.3 (D), R31.1
unnamed: Q6.1 (G), Q9.3 (D), R30.2
unnamed: Q6.3 (D), R41.1
unnamed: R22.2, SW3.1
RESETn: R27.2; also elsewhere on the board
RST_TVS: Q2.1 (G), R27.1, R28.1, SW3.2, TP56.1; also elsewhere on the board
SNS_0: R41.2, R45.1, TP7.1; also elsewhere on the board
SNS_1: R31.2, R44.1, TP6.1; also elsewhere on the board
SNS_2: R24.2, R43.1, TP5.1; also elsewhere on the board
SNS_EN: Q7.1 (G), Q8.1 (G), Q9.1 (G); also elsewhere on the board
VDD_BAT: D7.2 (A), J14.2, Q1.2 (D), Q1.4 (D), TP52.1; also elsewhere on the board

Notes on the sheet:
BATTERY TAP
INDICATE POS AND NEG ON SILKSCREEN
INDICATE VOLTAGES ON SILKSCREEN
PLACE TVS NEAR BUTTON PINS
SILK: OFF
SILK: ON
BATTERY PORT
CHARGING PORT
CHARGING TAP
INDICATE TP VOLTAGES ON SILKSCREEN

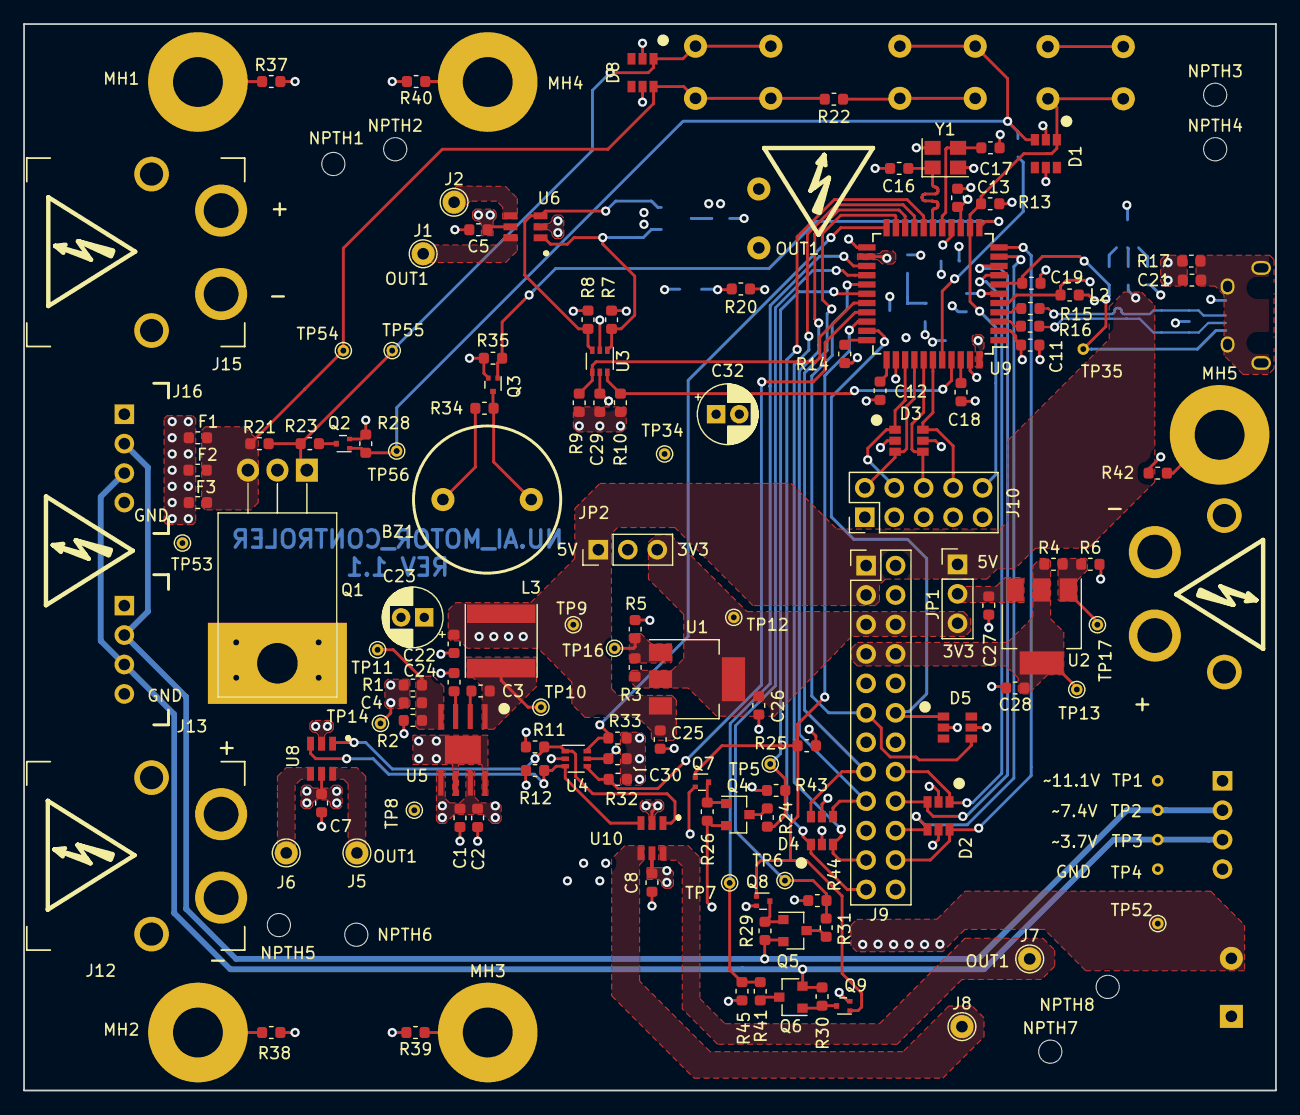
[picture p23: board nu.ai_motor_controller.kicad_pcb from above]

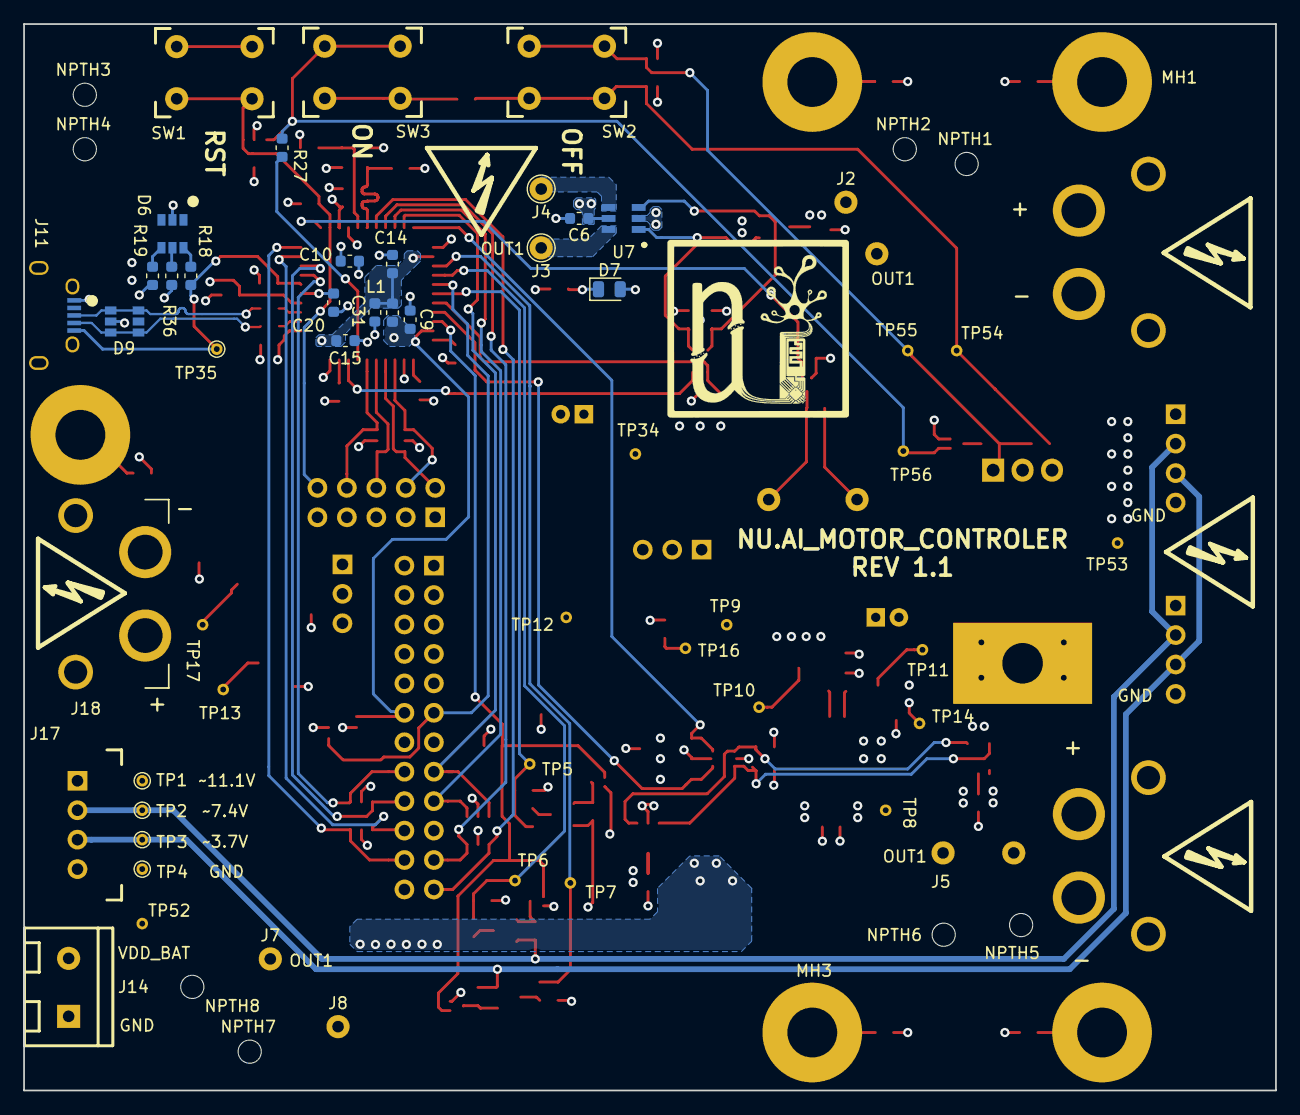
[picture p24: board nu.ai_motor_controller.kicad_pcb from below]

Board: 4 copper layers, 108.0 x 92.0 mm, 172 parts (30 on the bottom side), 87 nets.
