DJ027X/nu.ai_motor_controller/(commit log)

2018-12-23 original commit
    [driver.sch, nu.kicad_pcb, nu.sch, power.sch]
2019-01-08 Added block diagram, and added some components to the schematic that will end up being removed :/
    [nu.sch, power.sch]
2019-01-14 Updated block diagram
    [nu.sch, power.sch]
2019-01-15 Added voltage sense lines to diagram, and selected atmega32u4 as uC. The 32u4 doesn't require an FT usb/serial converter
2019-01-16 added microcontroller sheet
    [driver.sch, microcontroller.sch, nu.sch, power.sch]
2019-01-16 fixed file name for project
    [driver.sch, microcontroller.sch, nu.kicad_pcb, nu.sch, power.sch]
2019-01-17 cleaned up and renamed project files. Changed custom library management scheme. It now resides in my homedir as a seperate git project, and is pointed to in kicad's symbol library manager
    [driver.sch, microcontroller.sch, nu.ai_motor_controller.kicad_pcb, nu.ai_motor_controller.sch, nu.sch, power.sch]
2019-01-17 Added termination resistors
    [microcontroller.sch]
2019-01-18 automated commit
    [microcontroller.sch]
